awojak/P600-Main-Board/README.md

# P600-Main-Board
Project of Main Board for P600. Design in KiCad.
