awojak/P600-Main-Board/BOM.xlsx

Sheet: New
Reference | Model | Producent | Value | Quantity | Cena jednostkowa | Cena | Opis | Footprint | Link | Typ | Stan Magazynowy | Minimalne zamówienie
C14 C11 C12 C13 C28 C25 C26 C27 | C0805C471J1GAC | KEMET | 470pF | 8 | 0.09147 | 0.73176 |  | Capacitor_SMD:C_0805_2012Metric | https://www.tme.eu/pl/details/c0805c471j1gac/kondensatory-mlcc-smd-0805/kemet/c0805c471j1gactu/ | SMD
C3 C2 C91 C90 C15 C1 | EEUFR1H121L | Panasonic | 120uF | 6 | 1.074 | 6.444 | Kondensator: elektrolityczny; niskoimpedancyjny; THT; 120uF; ±20% | Capacitor_THT:CP_Radial_D8.0mm_P3.50mm | https://www.tme.eu/pl/details/eeufr1h121l/kondensatory-elektr-tht-niskoimpedan/panasonic/ | THT
C30 C29 | C0603C200J5GAC | KEMET | 20pF | 2 | 0.14766 | 0.29532 |  | Capacitor_SMD:C_0603_1608Metric | https://www.tme.eu/pl/details/c0603c200j5gac/kondensatory-mlcc-smd-0603/kemet/c0603c200j5gactu/ | SMD
C36 C93 | CL21B105KBFNNNE | SAMSUNG | 1uF | 2 | 0.09 | 0.18 |  | Capacitor_SMD:C_0603_1608Metric |  | SMD | 100
C4 C87 C16 C92 | CL32B106KBJNNNE | SAMSUNG | 10uF | 4 | 1.4525 | 5.81 | Kondensator: ceramiczny; MLCC; 10uF; 50V; X7R; ±10%; SMD; 1210 | Capacitor_SMD:C_1210_3225Metric | https://www.tme.eu/pl/details/cl32b106kbjnnne/kondensatory-mlcc-smd-1210/samsung/ | SMD
C5 C6 C8 C10 C89 C19 C20 C22 C24 C18 C31 C37 C38 C39 C40 C41 C42 C35 C34 C94 C47 C43 C44 C45 C46 C48 C61 C51 C69 C70 C68 C67 C75 C84 C77 C81 C82 C79 C80 C78 C83 C95 | CL10B104KB8NNNC | SAMSUNG | 0.1uF | 42 | 0.05982 | 2.51244 |  | Capacitor_SMD:C_0603_1608Metric |  | SMD | 100
C54 C55 C50 C52 C53 C49 | CL31B225KBHNNNE | SAMSUNG | 2.2uF | 6 | 0.68179 | 4.09074 |  | Capacitor_SMD:C_1206_3216Metric | https://www.tme.eu/pl/details/cl31b225kbhnnne/kondensatory-mlcc-smd-1206/samsung/ | SMD | 100
C56 |  |  | 47nF | 1 | 0 | 0 |  | Capacitor_SMD:C_0603_1608Metric |  | SMD
C60 | CL10B102KB8NNNC | SAMSUNG | 1nF | 1 | 0.05563 | 0.05563 | Kondensator: ceramiczny; MLCC; 1nF; 50V; X7R; ±10%; SMD; 0603 | Capacitor_SMD:C_0603_1608Metric | https://www.tme.eu/pl/details/cl10b102kb8nnnc/kondensatory-mlcc-smd-0603/samsung/ | SMD
C62 C64 C63 C57 C58 C65 | CL31B106KAHNNNE | SAMSUNG | 10uF | 6 | 0.26552 | 1.59312 |  | Capacitor_SMD:C_1206_3216Metric |  | SMD
C66 C86 C85 |  |  | 0.01uF | 3 | 0 | 0 |  | Capacitor_SMD:C_0603_1608Metric |  | SMD
C7 C21 C59 | CC0603KRX7R9223 | YAGEO | 22nF | 3 | 0.07284 | 0.21852 |  | Capacitor_SMD:C_0603_1608Metric | https://www.tme.eu/pl/details/cc0603krx7r9223/kondensatory-mlcc-smd-0603/yageo/cc0603krx7r9bb223/ | SMD
C73 C71 C74 C72 |  |  | NI | 4 | 0 | 0 |  | Capacitor_SMD:C_0603_1608Metric |  | SMD
C76 |  |  | NI | 1 | 0 | 0 |  | Capacitor_SMD:C_0805_2012Metric |  | SMD
C88 C17 | CL21B105KBFNNNE | SAMSUNG | 1uF | 2 | 0.09 | 0.18 |  | Capacitor_SMD:C_0805_2012Metric |  | SMD
C9 C23 C33 C32 | CL10A225KP8NNNC | SAMSUNG | 2.2uF | 4 | 0.08 | 0.32 |  | Capacitor_SMD:C_0603_1608Metric | https://www.tme.eu/pl/details/cl10a225kp8nnnc/kondensatory-mlcc-smd-0603/samsung/ | SMD
D1 D4 D3 D2 D6 D5 D7 D10 D9 D8 D12 D11 D18 D38 D39 |  | STM | SMAJ26CA | 15 | 0.3 | 4.5 | Dioda: transil; 400W; 28,9V; 43A; dwukierunkowa; SMA | Diode_SMD:D_SMA | https://www.tme.eu/pl/details/smaj26ca-tr/diody-transil-smd-dwukierunkowe/stmicroelectronics/smaj26ca/ | SMD
D13 D16 | OF-SMD2012G-1 | OPTOFLASH | OF-SMD2012G-1 | 2 | 0.34 | 0.68 | LED; SMD; 0805; zielony; 600-800mcd; 2x1,25x0,68mm; 120°; 2,8-3,4V | Diode_SMD:D_0805_2012Metric | https://www.tme.eu/pl/details/of-smd2012g-1/diody-led-smd-kolorowe/optoflash/ | SMD
D14 D15 D35 D36 D37 D45 D44 | SD05C.TCT | SEMTECH | SD05C.TCT | 7 | 0.9302 | 6.5114 | Dioda: transil; 350W; 6V; 24A; dwukierunkowa; SOD323 | Diode_SMD:D_SOD-323 | https://www.tme.eu/pl/details/sd05c.tct/diody-transil-smd-dwukierunkowe/semtech/ | SMD
D20 | MMSZ5240B-7-F | DIODES INCORPORATED | MMSZ5240B-7-F | 1 | 0.10646 | 0.10646 | Dioda: Zenera; 0,37/0,5W; 10V; SMD; rolka,taśma; SOD123 | Diode_SMD:D_SOD-123 | https://www.tme.eu/pl/details/mmsz5240b-7-f/diody-zenera-smd/diodes-incorporated/ | SMD
D24 | MMSZ5236BS-7-F | DIODES INCORPORATED | MMSZ5236BS-7-F | 1 | 0.14862 | 0.14862 | Dioda: Zenera; 0,2W; 7,5V; SMD; rolka,taśma; SOD323 | Diode_SMD:D_SOD-323 | https://www.tme.eu/pl/details/mmsz5236bs-7-f/diody-zenera-smd/diodes-incorporated/ | SMD
D25 D22 | B140-13-F | DIODES INCORPORATED | B140-13-F | 2 | 0.2938 | 0.5876 | Dioda: prostownicza Schottky; SMD; 40V; 1A; SMA | Diode_SMD:D_SMA | https://www.tme.eu/pl/details/b140-13-f/diody-schottky-smd/diodes-incorporated/ | SMD
D26 | SK35SMA | DIODES INCORPORATED | SK35SMA | 1 | 0.3496 | 0.3496 | Dioda: prostownicza Schottky; SMD; 50V; 3A; SMA | Diode_SMD:D_SMA | https://www.tme.eu/pl/details/sk35sma-dio/diody-schottky-smd/diotec-semiconductor/sk35sma/ | SMD
D27 D23 D29 D34 D28 D30 D31 D32 D33 | 1N4448WS-7-F | DIODES INCORPORATED | 1N4448WS-7-F | 9 | 0.14905 | 1.34145 | Dioda: prostownicza; SMD; 75V; 0,25A; 4ns; | Diode_SMD:D_SOD-323 | https://www.tme.eu/pl/details/1n4448ws-7-f/diody-uniwersalne-smd/diodes-incorporated/ | SMD
D43 D42 D41 D40 | SKL32 | DIOTEC SEMICONDUCTOR | SKL32 | 4 | 0.3028 | 1.2112 | Dioda: prostownicza Schottky; SMD; 20V; 3A; SOD123F | Diode_SMD:D_SOD-123F | https://www.tme.eu/pl/details/skl32-dio/diody-schottky-smd/diotec-semiconductor/skl32/ | SMD
F1 | 0ZCF0185FF2C | BEL FUSE | 0ZCF0185FF2C | 1 | 0.8689 | 0.8689 | Bezpiecznik: polimerowy PTC; 1,85A; Imax: 100A; Obud: 2920; 0ZCF | Fuse:Fuse_2920_7451Metric | https://www.tme.eu/pl/details/0zcf0185ff2c/bezpieczniki-polimerowe-smd/bel-fuse/ | SMD
F2 F3 | 0ZCJ0050AF2E | BEL FUSE | 0ZCJ0050AF2E | 2 | 0.6728 | 1.3456 | Bezpiecznik: polimerowy PTC; 500mA; Imax: 100A; Obud: 1206; 0ZCJ | Fuse:Fuse_1206_3216Metric | https://www.tme.eu/pl/details/0zcj0050af2e/bezpieczniki-polimerowe-smd/bel-fuse/ | SMD
F4 | 0ZCK0100FF2E | BEL FUSE | 0ZCK0100FF2E | 1 | 1.04 | 1.04 | Bezpiecznik: polimerowy PTC; 1A; Imax: 40A; Obud: 0805; 0ZCK | Fuse:Fuse_0805_2012Metric | https://www.tme.eu/pl/details/0zck0100ff2e/bezpieczniki-polimerowe-smd/bel-fuse/ | SMD
F5 F7 | SR050-06 | ECE | SR050 | 2 | 0.906 | 1.812 | Bezpiecznik: polimerowy PTC; 500mA; Obud: 0805 | Fuse:Fuse_0805_2012Metric | https://www.tme.eu/pl/details/sr050-06/bezpieczniki-polimerowe-smd/ece/ | SMD
F6 | SN010-60 | ECE | SN010-60 | 1 | 0.3763 | 0.3763 | Bezpiecznik: polimerowy PTC; 100mA; Obud: 1206 | Fuse:Fuse_1206_3216Metric | https://www.tme.eu/pl/details/sn010-60/bezpieczniki-polimerowe-smd/ece/ | SMD
FB1 FB2 FB3 FB4 FB5 FB6 FB7 FB8 | BLM21PG600SN1D | MURATA | 60Ohm@100MHz | 8 | 0.13674 | 1.09392 | Ferryt: koralik; Imp.@ 100MHz: 60Ω; Montaż: SMD; 3A; Obud: 0805 | Inductor_SMD:L_0805_2012Metric | https://www.tme.eu/pl/details/blm21pg600sn1d/ferryty-koraliki/murata/ | SMD
FB9 | BLM18TG601TN1D | MURATA | 600Ohm@100MHz | 1 | 0.03481 | 0.03481 | Ferryt: koralik; Imp.@ 100MHz: 600Ω; Montaż: SMD; 0.2A; Obud: 0603 | Inductor_SMD:L_0603_1608Metric | https://www.tme.eu/pl/details/blm18tg601tn1d/ferryty-koraliki/murata/ | SMD
J3 | MC32597 | MULTICOMP PRO | USB_B | 1 | 2.73 | 2.73 | Złącze USB, USB typu B, USB 2.0, Gniazdo, 4 tory/-ów, Montaż przewlekany, Pionowe | Connector_USB:USB_B_TE_5787834_Vertical | https://pl.farnell.com/multicomp/mc32597/usb-2-0-type-b-receptacle-th/dp/1696538?MER=sy-me-pd-mi-alte | THT
J1 J2 | B4B-XH-A | JST |  | 2 | 0.81567 | 1.63134 | Gniazdo; przewód-płytka; męskie; XH; 2,5mm; PIN: 4; THT; 250V; 3A | Connector_JST:JST_XH_B4B-XH-AM_1x04_P2.50mm_Vertical | https://www.tme.eu/pl/details/b4b-xh-a/zlacza-sygnalowe-raster-2-50mm/jst/ | THT | 5
J10 J11 |  |  |  | 2 | 0.8 | 1.6 |  | footprints:THT_FPC_r1.0mm_11pin_vertical | https://pl.aliexpress.com/item/33053158233.html?spm=a2g0o.cart.0.0.1df73c00waDDo7&mp=1 | THT
J43 J33 J32 J29 J28 J27 J25 J21 J12 J13 J14 J15 J5 | B3B-PH-K-S | JST |  | 13 | 0.59599 | 7.74787 | Gniazdo; przewód-płytka; męskie; PH; 2mm; PIN: 3; THT; 100V; 2A | Connector_JST:JST_PH_B3B-PH-K_1x03_P2.00mm_Vertical | https://www.tme.eu/pl/details/b3b-ph-k-s/zlacza-sygnalowe-raster-2-00mm/jst/ | THT
J16 | B2B-XH-A | JST | Power Input | 1 | 0.49272 | 0.49272 | Gniazdo; przewód-płytka; męskie; XH; 2,5mm; PIN: 2; THT; 250V; 3A | Connector_JST:JST_XH_B2B-XH-AM_1x02_P2.50mm_Vertical | https://www.tme.eu/pl/details/b2b-xh-a/zlacza-sygnalowe-raster-2-50mm/jst/ | THT | 10
J42 J41 J40 J39 J38 J37 J31 J30 J24 J23 J22 J20 J17 J18 J19 J6 J7 J8 J9 | B2B-PH-K-S | JST |  | 19 | 0.47429 | 9.01151 | Gniazdo; przewód-płytka; męskie; PH; 2mm; PIN: 2; THT; 100V; 2A | Connector_JST:JST_PH_B2B-PH-K_1x02_P2.00mm_Vertical | https://www.tme.eu/pl/details/b2b-ph-k-s/zlacza-sygnalowe-raster-2-00mm/jst/ | THT | 20
J36 J26 | B4B-PH-K-S | JST | ANALOG | 2 | 0.78136 | 1.56272 | Gniazdo; przewód-płytka; męskie; PH; 2mm; PIN: 4; THT; 100V; 2A | Connector_JST:JST_PH_B4B-PH-K_1x04_P2.00mm_Vertical | https://www.tme.eu/pl/details/b4b-ph-k-s/zlacza-sygnalowe-raster-2-00mm/jst/ | THT | 5
J34 | B10B-PH-K-S | JST | Display | 1 | 1.33 | 1.33 | Złącze przewód-płytka, pionowe, 2 mm, 10 styki/-ów, Header, Seria PH, Przewlekane, 1 rzędy/-ów | Connector_JST:JST_PH_B10B-PH-K_1x10_P2.00mm_Vertical | https://pl.farnell.com/jst-japan-solderless-terminals/b10b-ph-k-s-lf-sn/header-tht-vertical-2mm-10way/dp/9491880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 | THT
J35 | B5B-PH-K-S | JST | SPI Interface | 1 | 0.90501 | 0.90501 | Gniazdo; przewód-płytka; męskie; PH; 2mm; PIN: 5; THT; 100V; 2A | Connector_JST:JST_PH_B5B-PH-K_1x05_P2.00mm_Vertical | https://www.tme.eu/pl/details/b5b-ph-k-s/zlacza-sygnalowe-raster-2-00mm/jst/ | THT | 5
K1 | S13-24V-2C | SHORI ELECTRIC | S13-24V-2C | 1 | 4.46 | 4.46 | Przekaźnik: elektromagnetyczny; DPDT; Ucewki : 24VDC; 0,5A/125VAC | footprints:Relay_DPDT_Omron_G5V-2 | https://www.tme.eu/pl/details/s13-24v-2c/przekazniki-elektromagn-miniaturowe/shori-electric/ | THT | 2
L1 | DJNR6045-150 | FERROCORE | DJNR6045-680 | 1 | 0.7018 | 0.7018 | Dławik: drutowy; SMD; 15uH; Ipracy: 2,3A; 100,1mΩ; 6x5,9x4,5mm; ±20% | footprints:L_6.2x6.2_H4.5 | https://www.tme.eu/pl/details/djnr6045-150/dlawiki-smd-mocy/ferrocore/ | SMD
L2 | DJNR6045-150 | FERROCORE | DJNR6045-150 | 1 | 0.7018 | 0.7018 | Dławik: drutowy; SMD; 15uH; Ipracy: 2,3A; 100,1mΩ; 6x5,9x4,5mm; ±20% | footprints:L_6.2x6.2_H4.5 | https://www.tme.eu/pl/details/djnr6045-150/dlawiki-smd-mocy/ferrocore/ | SMD
L3 | DJNR6045-6R8 | FERROCORE | DJNR6045-6R8 | 1 | 0.7018 | 0.7018 | Dławik: drutowy; SMD; 6,8uH; Ipracy: 3,5A; 49,4mΩ; 6x5,9x4,5mm; ±20% | footprints:L_6.2x6.2_H4.5 | https://www.tme.eu/pl/details/djnr6045-6r8/dlawiki-smd-mocy/ferrocore/ | SMD
Q1 Q2 Q3 Q4 Q6 Q5 Q7 Q10 Q9 Q14 Q15 Q16 Q19 Q18 Q20 Q21 | 2N7002KT1G | ON SEMICONDUCTOR | 2N7002K | 16 | 0.08831 | 1.41296 | Tranzystor: N-MOSFET ESD Protected; unipolarny; 60V; 0,38A; 0,42W; SOT23-3 | Package_TO_SOT_SMD:SOT-23 | https://www.tme.eu/pl/details/2n7002kt1g/tranzystory-z-kanalem-n-smd/on-semiconductor/ | SMD
Q11 Q12 Q13 Q17 | BC817.215 | NEXPERIA | BC817 | 4 | 0.1189 | 0.4756 | Tranzystor: NPN; bipolarny; 45V; 0,5A; 250mW; SOT23 | Package_TO_SOT_SMD:SOT-23 | https://www.tme.eu/pl/details/bc817.215/tranzystory-npn-smd/nexperia/ | SMD | 100
Q8 | YJS9435A | YANGJIE TECHNOLOGY | YJS9435A | 1 | 0.29736 | 0.29736 | Tranzystor: P-MOSFET; TRENCH POWER LV; unipolarny; -30V; -4,1A | Package_SO:SOP-8_3.9x4.9mm_P1.27mm | https://www.tme.eu/pl/details/yjs9435a-yan/tranzystory-z-kanalem-p-smd/yangjie-technology/yjs9435a/ | SMD
R10 R53 |  |  | 47Ω | 2 | 0.04651 | 0.09302 |  | Resistor_SMD:R_0603_1608Metric |  | SMD
R12 R11 R57 R51 R60 R63 R80 R104 R108 R105 R109 R102 R106 R103 R107 R117 R118 R119 R120 R1 | 0603SAF1002T5E | ROYAL OHM | 10kΩ | 20 | 0.03622 | 0.7244 | Rezystor: thick film; SMD; 0603; 10kΩ; 0,1W; ±1%; -55-155°C | Resistor_SMD:R_0603_1608Metric | https://www.tme.eu/pl/details/smd0603-10k-1%25/rezystory-smd-0603/royal-ohm/0603saf1002t5e/ | SMD
R13 R33 R34 R32 R36 R37 R111 |  |  | 0Ω | 7 | 0.04651 | 0.32557 |  | Resistor_SMD:R_0603_1608Metric |  | SMD
R14 R17 R100 R101 R47 |  |  | 330Ω | 5 | 0.04651 | 0.23255 |  | Resistor_SMD:R_0603_1608Metric |  | SMD
R18 R19 R20 R21 R62 R61 R112 R110 | SMD0603-4K7-1% | ROYAL OHM | 2.2kΩ | 8 | 0.04651 | 0.37208 | Rezystor: thick film; SMD; 0603; 4,7kΩ; 0,1W; ±1%; -55-155°C | Resistor_SMD:R_0603_1608Metric | https://www.tme.eu/pl/details/smd0603-4k7-1%25/rezystory-smd-0603/royal-ohm/0603saf4701t5e/ | SMD
R2 R6 R31 R42 R43 R44 | 0603SAF1001T5E | ROYAL OHM | 1kΩ | 6 | 0.04651 | 0.27906 | Rezystor: thick film; SMD; 0603; 1kΩ; 0,1W; ±1%; -55-155°C | Resistor_SMD:R_0603_1608Metric | https://www.tme.eu/pl/details/smd0603-1k-1%25/rezystory-smd-0603/royal-ohm/0603saf1001t5e/ | SMD
R22 R23 R24 R25 R38 R30 R41 R66 R65 R86 R85 R87 R98 R99 R113 R114 | 0603SAF1000T5E | ROYAL OHM | 100Ω | 16 | 0.03185 | 0.5096 | Rezystor: thick film; SMD; 0603; 100Ω; 0,1W; ±1%; -55-155°C | Resistor_SMD:R_0603_1608Metric | https://www.tme.eu/pl/details/smd0603-100r-1%25/rezystory-smd-0603/royal-ohm/0603saf1000t5e/ | SMD
R26 R27 R28 R29 R40 R72 R73 R71 R70 R84 R93 R115 R116 | 0603SAJ0473T5E | ROYAL OHM | 20kΩ | 13 | 0.03572 | 0.46436 | Rezystor: thick film; SMD; 0603; 47kΩ; 0,1W; ±5%; -55-155°C | Resistor_SMD:R_0603_1608Metric | https://www.tme.eu/pl/details/smd0603-47k/rezystory-smd-0603/royal-ohm/0603saj0473t5e/ | SMD
R3 R7 R39 R52 R48 R64 R68 R82 R67 R69 R83 R91 R95 R94 R92 |  |  | 100kΩ | 15 | 0.04651 | 0.69765 |  | Resistor_SMD:R_0603_1608Metric |  | SMD
R35 R81 R74 R75 R78 R76 R77 R79 |  |  | NI | 8 | 0 | 0 |  | Resistor_SMD:R_0603_1608Metric |  | SMD
R4 R5 R8 R9 | CS10FTFTR100 | VIKING | 100mΩ | 4 | 0.76246 | 3.04984 | Rezystor: thick film; pomiarowy; SMD; 2010; 100mΩ; 1W; ±1% | Resistor_SMD:R_2010_5025Metric | https://www.tme.eu/pl/details/cs2010-0r1-1%25-hp/rezystory-smd-2010/viking/cs10ftftr100/ | SMD
R45 |  |  | 10kΩ | 1 | 0.04651 | 0.04651 |  | Resistor_SMD:R_0805_2012Metric |  | SMD
R50 | MCWR06X3162FTL | MULTICOMP PRO | 140kΩ | 1 | 0.02 | 0.02 | Rezystor SMD, grubowarstwowy, 0603 [jedn. metryczne: 1608], 31.6 kohm, Seria MCWR, 75 V | Resistor_SMD:R_0603_1608Metric | https://pl.farnell.com/multicomp/mcwr06x3162ftl/res-31k6-1-0-1w-thick-film/dp/2447337RL | SMD
R55 R54 | 6-1622825-5 | TE Connectivity | 100mΩ | 2 | 0.33547 | 0.67094 | Rezystor: metal glaze; SMD; 1206; 100mΩ; 0,25W; ±5%; 200ppm/°C | Resistor_SMD:R_1206_3216Metric | https://www.tme.eu/pl/details/smd1206-r10-lo/rezystory-smd-1206/te-connectivity/6-1622825-5/ | SMD
R56 | MCWR06X3162FTL | MULTICOMP PRO | 31.2kΩ | 1 | 0.02 | 0.02 | Rezystor SMD, grubowarstwowy, 0603 [jedn. metryczne: 1608], 31.6 kohm, Seria MCWR, 75 V | Resistor_SMD:R_0603_1608Metric | https://pl.farnell.com/multicomp/mcwr06x3162ftl/res-31k6-1-0-1w-thick-film/dp/2447337RL | SMD
R58 | 0603SAF3921T5E | ROYAL OHM | 3.92kΩ | 1 | 0.05158 | 0.05158 | Rezystor: thick film; SMD; 0603; 3,92kΩ; 0,1W; ±1%; -55-155°C | Resistor_SMD:R_0603_1608Metric | https://www.tme.eu/pl/details/smd0603-3.92k-1%25/rezystory-smd-0603/royal-ohm/0603saf3921t5e/ | SMD
R59 |  |  | 750Ω | 1 | 0.04651 | 0.04651 |  | Resistor_SMD:R_0603_1608Metric |  | SMD
R88 |  |  | 0Ω | 1 | 0 | 0 |  | Resistor_SMD:R_0805_2012Metric |  | SMD
R89 R90 |  |  | NI | 2 | 0 | 0 |  | Resistor_SMD:R_0805_2012Metric |  | SMD
R96 R97 |  |  | 20Ω | 2 | 0 | 0 |  | Resistor_SMD:R_0603_1608Metric |  | SMD
RN1 RN2 RN3 RN4 | 4D03WGJ0331T | ROYAL OHM | 330Ω | 4 | 0.04823 | 0.19292 | Drabinka rezystorowa: Y; 330Ω; SMD; 1206; Il.rezystorów: 4; 63mW | Resistor_SMD:R_Array_Convex_4x0603 | https://www.tme.eu/pl/details/dr1206-330r-4_8/drabinki-rezystorowe-smd/royal-ohm/4d03wgj0331t/ | SMD
U1 U2 | TMC2209-LA-T | TRINAMIC | TMC2209-LA | 2 | 10.3 | 20.6 | Sterownik/kontroler silnika krokowego, 4.75V do 29V, 2A/1 wyjście, QFN-28 | footprints:QFN-28_5X5mm_P0.5mm_EP3.35x.3.35mm | https://pl.farnell.com/trinamic/tmc2209-la-t/motor-driver-stepper-qfn-28/dp/3131535?st=TMC2209 | SMD
U10 | 74HC2G32DC.125 | NEXPERIA | 74HC2G32 | 1 | 1.1252 | 1.1252 | IC: cyfrowy; OR; Kanały: 2; IN: 4; CMOS; SMD; VSSOP8; Seria: HC; 2-6VDC | Package_SO:VSSOP-8_2.3x2mm_P0.5mm | https://www.tme.eu/pl/details/74hc2g32dc.125/bramki-inwertery/nexperia/ | SMD
U12 | SHTC3 | SENSIRION | SHTC3 | 1 | 7.2 | 7.2 | Czujnik: temperatury i wilgotności; Zakres: 0-100% RH; -0,3-4VDC | footprints:DFN-4-1EP_2x2mm_P1mm_EP0.7x1.6mm | https://www.tme.eu/pl/details/shtc3/czujniki-wilgotnosci/sensirion/3-000-047/ | SMD | 2
U13 | M24C02-WDW6TP | ST | M24C02-WDW | 1 | 0.56 | 0.56 | EEPROM, 2 Kbit, 256 x 8 bitów, Szeregowy I2C (2-Wire), 400 kHz, TSSOP, 8 piny/-ów | Package_SO:TSSOP-8_4.4x3mm_P0.65mm | https://pl.farnell.com/stmicroelectronics/m24c02-wdw6tp/eeprom-2kbit-i2c-400khz-tssop/dp/2849956RL | SMD
U3 | STM32F401VBT6 | STM | STM32F401VETx | 1 | 22.53 | 22.53 | ARM MCU, linia Dynamic Efficiency, STM32 Family STM32F4 Series Microcontrollers, ARM Cortex-M4 | Package_QFP:LQFP-100_14x14mm_P0.5mm | https://pl.farnell.com/stmicroelectronics/stm32f401vbt6/mcu-32bit-cortex-m4-84mhz-lqfp/dp/2393646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 | SMD | 2
U4 | USBUF02W6 | STM | USBUF02W6 | 1 | 1.0587 | 1.0587 | Filtr: cyfrowy; line terminator; EMI,dolnoprzepustowy; SOT323-6L | footprints:SOT323-6L | https://www.tme.eu/pl/details/usbuf02w6/filtry-uklady-scalone/stmicroelectronics/ | SMD | 25
U5 U11 | 74HC245PW.112 | NEXPERIA | 74HC245 | 2 | 0.974 | 1.948 | IC: cyfrowy; bus transceiver; Kanały: 8; SMD; TSSOP20; Seria: HC | Package_SO:TSSOP-20_4.4x6.5mm_P0.65mm | https://www.tme.eu/pl/details/74hc245pw.112/bufory-nadajniki-sterowniki/nexperia/ | SMD | 4
U7 | A4403GEUTR-T | ALLEGRO | A4403 | 1 | 6.66 | 6.66 | PMIC; przetwornica DC/DC; Upracy: 9-46V; Uwyj: 46V; QFN16; buck | Package_DFN_QFN:QFN-16-1EP_4x4mm_P0.65mm_EP2.7x2.7mm | https://www.tme.eu/pl/details/a4403geutr-t/regulatory-napiecia-uklady-dc-dc/allegro-microsystems/ | SMD | 2
U8 U6 | MCP16301T-I/CHY | MICROCHIP | MCP16301 | 2 | 3.82 | 7.64 | PMIC; przetwornica DC/DC; Upracy: 4-30V; Uwyj: 2-15V; SOT23-6; buck | Package_TO_SOT_SMD:SOT-23-6 | https://www.tme.eu/pl/details/mcp16301t-i_chy/regulatory-napiecia-uklady-dc-dc/microchip-technology/ | SMD | 2
U9 | MCP6002T-I/SN | MICROCHIP | MCP6002-xSN | 1 | 2.07 | 2.07 | Wzmacniacz operacyjny; 1MHz; 1,8-5,5V; Kanały: 2; SO8 | Package_SO:SOIC-8_3.9x4.9mm_P1.27mm | https://www.tme.eu/pl/details/mcp6002t-i_sn/wzmacniacze-operacyjne-smd/microchip-technology/ | SMD
Y1 | 8M-49S-SR | SR PASSIVES | 8MHz | 1 | 1.6356 | 1.6356 | Rezonator: kwarcowy; 8MHz; ±30ppm; 20pF; THT; HC49-S | Crystal:Crystal_HC49-4H_Vertical | https://www.tme.eu/pl/details/8m-49s-sr/rezonatory-kwarcowe-tht/sr-passives/ | THT | 5
Płytka PCB |  |  |  | 1 | 31 | 31 |  |  |  |  |  | 5
 |  |  |  | Razem |  | 192.02597

Sheet: BOM KiCad
Reference | Quantity | Value | Footprint | Cena [netto] | Link | Model | Opis | Producent | Typ
Q4 | 1 | YJS9435A | Package_SO:SOP-8_3.9x4.9mm_P1.27mm | 0.30 | https://www.tme.eu/pl/details/yjs9435a-yan/tranzystory-z-kanalem-p-smd/yangjie-technology/yjs9435a/ | YJS9435A | Tranzystor: P-MOSFET; TRENCH POWER LV; unipolarny; -30V; -4,1A | YANGJIE TECHNOLOGY | SMD
U4 | 1 | USBUF02W6 | footprints:SOT323-6L | 1.06 | https://www.tme.eu/pl/details/usbuf02w6/filtry-uklady-scalone/stmicroelectronics/ | USBUF02W6 | Filtr: cyfrowy; line terminator; EMI,dolnoprzepustowy; SOT323-6L | STM | SMD
U1 U2 | 2 | TMC2209-LA | footprints:TMC2209-LA | 10.30 | https://pl.farnell.com/trinamic/tmc2209-la-t/motor-driver-stepper-qfn-28/dp/3131535?st=TMC2209 | TMC2209-LA-T | Sterownik/kontroler silnika krokowego, 4.75V do 29V, 2A/1 wyjĹ›cie, QFN-28 | TRINAMIC | SMD
J4 | 1 | SWD | Connector_IDC:IDC-Header_2x03_P2.54mm_Vertical | 1.58 | https://www.tme.eu/pl/details/t821-1-06-s1/zlacza-idc/amphenol/t821106a1s100ceu/ | T821106A1S100CEU | Gniazdo; IDC; mÄ™skie; PIN: 6; proste; THT; zĹ‚ocony; 2,54mm; UkĹ‚ad: 2x3 | AMPHENOL | THT
U3 | 1 | STM32F401VETx | Package_QFP:LQFP-100_14x14mm_P0.5mm | 22.53 | https://pl.farnell.com/stmicroelectronics/stm32f401vbt6/mcu-32bit-cortex-m4-84mhz-lqfp/dp/2393646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 | STM32F401VBT6 | ARM MCU, linia Dynamic Efficiency, STM32 Family STM32F4 Series Microcontrollers, ARM Cortex-M4 | STM | SMD
F2 F1 F8 | 3 | SR050 | Fuse:Fuse_0805_2012Metric | 0.91 | https://www.tme.eu/pl/details/sr050-06/bezpieczniki-polimerowe-smd/ece/ | SR050-06 | Bezpiecznik: polimerowy PTC; 500mA; Obud: 0805 | ECE | SMD
F7 F9 | 2 | SR010 | Fuse:Fuse_0805_2012Metric | 0.62 | https://www.tme.eu/pl/details/sr010-15/bezpieczniki-polimerowe-smd/ece/ | SR010-15 | Bezpiecznik: polimerowy PTC; 100mA; Obud: 0805 | ECE | SMD
F4 F5 F6 | 3 | SN010-60 | Fuse:Fuse_1206_3216Metric | 0.38 | https://www.tme.eu/pl/details/sn010-60/bezpieczniki-polimerowe-smd/ece/ | SN010-60 | Bezpiecznik: polimerowy PTC; 100mA; Obud: 1206 | ECE | SMD
R33 R31 R20 R21 R18 R19 R35 R66 R67 R64 R65 R60 R61 | 13 | 4.7kÎ© | Resistor_SMD:R_0603_1608Metric | 0.05 | https://www.tme.eu/pl/details/smd0603-4k7-1%25/rezystory-smd-0603/royal-ohm/0603saf4701t5e/ | SMD0603-4K7-1% | Rezystor: thick film; SMD; 0603; 4,7kÎ©; 0,1W; Â±1%; -55Ă·155Â°C | ROYAL OHM | SMD
D25 | 1 | SK35SMA | Diode_SMD:D_SMA | 0.35 | https://www.tme.eu/pl/details/sk35sma-dio/diody-schottky-smd/diotec-semiconductor/sk35sma/ | SK35SMA | Dioda: prostownicza Schottky; SMD; 50V; 3A; SMA | DIODES INCORPORATED | SMD
D7 D5 D3 D1 D2 D4 D6 D8 D15 D13 D11 D9 D10 D12 D14 D16 | 16 | SK25 | Diode_SMD:D_SMB | 0.24 | https://www.tme.eu/pl/details/sk25-dio/diody-schottky-smd/diotec-semiconductor/sk25/ | SK25 | Dioda: prostownicza Schottky; SMD; 50V; 2A; SMB | DIOTEC SEMICONDUCTOR | SMD
U10 | 1 | SHTC3 | footprints:DFN-4-1EP_2x2mm_P1mm_EP0.7x1.6mm | 7.20 | https://www.tme.eu/pl/details/shtc3/czujniki-wilgotnosci/sensirion/3-000-047/ | SHTC3 | Czujnik: temperatury i wilgotnoĹ›ci; Zakres: 0Ă·100% RH; -0,3Ă·4VDC | SENSIRION | SMD
K1 | 1 | S13-24V-2C | footprints:Relay_DPDT_Omron_G5V-2 | 4.46 | https://www.tme.eu/pl/details/s13-24v-2c/przekazniki-elektromagn-miniaturowe/shori-electric/ | S13-24V-2C | PrzekaĹşnik: elektromagnetyczny; DPDT; Ucewki : 24VDC; 0,5A/125VAC | SHORI ELECTRIC | THT
D20 | 1 | P4SMA30CA | Diode_SMD:D_SMA | 0.61 | https://www.tme.eu/pl/details/p4sma30ca-yan/diody-transil-smd-dwukierunkowe/yangjie-technology/p4sma30ca/ | P4SMA30CA | Dioda: transil; 400W; 30V; 9,6A; dwukierunkowa; Â±5% | YANGJIE TECHNOLOGY | SMD
D17 D23 D19 D21 | 4 | OF-SMD2012G-1 | Diode_SMD:D_0805_2012Metric | 0.34 | https://www.tme.eu/pl/details/of-smd2012g-1/diody-led-smd-kolorowe/optoflash/ | OF-SMD2012G-1 | LED; SMD; 0805; zielony; 600Ă·800mcd; 2x1,25x0,68mm; 120Â°; 2,8Ă·3,4V | OPTOFLASH | SMD
D22 | 1 | MMSZ5240B-7-F | Diode_SMD:D_SOD-123 | 0.11 | https://www.tme.eu/pl/details/mmsz5240b-7-f/diody-zenera-smd/diodes-incorporated/ | MMSZ5240B-7-F | Dioda: Zenera; 0,37/0,5W; 10V; SMD; rolka,taĹ›ma; SOD123 | DIODES INCORPORATED | SMD
R45 | 1 | 31.2kÎ© | Resistor_SMD:R_0603_1608Metric | 0.02 | https://pl.farnell.com/multicomp/mcwr06x3162ftl/res-31k6-1-0-1w-thick-film/dp/2447337RL | MCWR06X3162FTL | Rezystor SMD, grubowarstwowy, 0603 [jedn. metryczne: 1608], 31.6 kohm, Seria MCWR, 75 V | MULTICOMP PRO | SMD
U7 | 1 | MCP16301 | Package_TO_SOT_SMD:SOT-23-6 | 3.82 | https://www.tme.eu/pl/details/mcp16301t-i_chy/regulatory-napiecia-uklady-dc-dc/microchip-technology/ | MCP16301T-I/CHY | PMIC; przetwornica DC/DC; Upracy: 4Ă·30V; Uwyj: 2Ă·15V; SOT23-6; buck | MICROCHIP | SMD
C1 C15 | 2 | 330uF | Capacitor_THT:CP_Radial_D10.0mm_P5.00mm | 0.67 |  | ED1H331MNN1025 |  | Elite | THT
L2 | 1 | DJNR6045-6R8 | footprints:L_6.2x6.2_H4.5 | 0.70 | https://www.tme.eu/pl/details/djnr6045-6r8/dlawiki-smd-mocy/ferrocore/ | DJNR6045-6R8 | DĹ‚awik: drutowy; SMD; 6,8uH; Ipracy: 3,5A; 49,4mÎ©; 6x5,9x4,5mm; Â±20% | FERROCORE | SMD
L1 | 1 | DJNR6045-150 | footprints:L_6.2x6.2_H4.5 | 0.70 | https://www.tme.eu/pl/details/djnr6045-150/dlawiki-smd-mocy/ferrocore/ | DJNR6045-150 | DĹ‚awik: drutowy; SMD; 15uH; Ipracy: 2,3A; 100,1mÎ©; 6x5,9x4,5mm; Â±20% | FERROCORE | SMD
R4 R5 R8 R9 | 4 | 100mÎ© | Resistor_SMD:R_2010_5025Metric | 0.76 | https://www.tme.eu/pl/details/cs2010-0r1-1%25-hp/rezystory-smd-2010/viking/cs10ftftr100/ | CS10FTFTR100 | Rezystor: thick film; pomiarowy; SMD; 2010; 100mÎ©; 1W; Â±1% | VIKING | SMD
C2 C16 | 2 | 10uF | Capacitor_SMD:C_1210_3225Metric | 1.45 |  | CL32B106KBJNNNE |  | SAMSUNG | SMD
C49 C50 | 2 | 2.2uF | Capacitor_SMD:C_1206_3216Metric | 0.68 | https://www.tme.eu/pl/details/cl31b225kbhnnne/kondensatory-mlcc-smd-1206/samsung/ | CL31B225KBHNNNE |  | SAMSUNG | SMD
C55 C57 C56 C58 | 4 | 10uF | Capacitor_SMD:C_1206_3216Metric | 0.27 |  | CL31B106KAHNNNE |  | SAMSUNG | SMD
C3 C17 | 2 | 1uF | Capacitor_SMD:C_0805_2012Metric | 0.09 |  | CL21B105KBFNNNE |  | SAMSUNG | SMD
C36 | 1 | 1uF | Capacitor_SMD:C_0603_1608Metric | 0.09 |  | CL21B105KBFNNNE |  | SAMSUNG | SMD
C5 C6 C8 C10 C4 C19 C20 C22 C24 C18 C31 C37 C38 C39 C40 C41 C42 C35 C34 C48 C54 C63 C68 | 23 | 0.1uF | Capacitor_SMD:C_0603_1608Metric | 0.06 |  | CL10B104KB8NNNC |  | SAMSUNG | SMD
C47 C45 C46 C43 C44 C53 C60 C61 C62 C66 C67 C64 C65 | 13 | 1nF | Capacitor_SMD:C_0603_1608Metric | 0.06 | https://www.tme.eu/pl/details/cl10b102kb8nnnc/kondensatory-mlcc-smd-0603/samsung/ | CL10B102KB8NNNC | Kondensator: ceramiczny; MLCC; 1nF; 50V; X7R; Â±10%; SMD; 0603 | SAMSUNG | SMD
C9 C23 C33 C32 | 4 | 2.2uF | Capacitor_SMD:C_0603_1608Metric | 0.08 | https://www.tme.eu/pl/details/cl10a225kp8nnnc/kondensatory-mlcc-smd-0603/samsung/ | CL10A225KP8NNNC |  | SAMSUNG | SMD
C7 C21 C52 | 3 | 22nF | Capacitor_SMD:C_0603_1608Metric | 0.07 | https://www.tme.eu/pl/details/cc0603krx7r9223/kondensatory-mlcc-smd-0603/yageo/cc0603krx7r9bb223/ | CC0603KRX7R9223 |  | YAGEO | SMD
C14 C11 C12 C13 C28 C25 C26 C27 | 8 | 470pF | Capacitor_SMD:C_0805_2012Metric | 0.09 | https://www.tme.eu/pl/details/c0805c471j1gac/kondensatory-mlcc-smd-0805/kemet/c0805c471j1gactu/ | C0805C471J1GAC |  | KEMET | SMD
C30 C29 | 2 | 20pF | Capacitor_SMD:C_0603_1608Metric | 0.15 | https://www.tme.eu/pl/details/c0603c200j5gac/kondensatory-mlcc-smd-0603/kemet/c0603c200j5gactu/ | C0603C200J5GAC |  | KEMET | SMD
FB1 FB2 FB3 FB4 FB5 FB6 FB7 FB8 | 8 | 60Ohm@100MHz | Inductor_SMD:L_0805_2012Metric | 0.14 | https://www.tme.eu/pl/details/blm21pg600sn1d/ferryty-koraliki/murata/ | BLM21PG600SN1D | Ferryt: koralik; Imp.@ 100MHz: 60Î©; MontaĹĽ: SMD; 3A; Obud: 0805 | MURATA | SMD
FB10 FB9 | 2 | 1000@100MHz | Inductor_SMD:L_0805_2012Metric | 0.28 | https://www.tme.eu/pl/details/blm21ag102sn1d/ferryty-koraliki/murata/ | BLM21AG102SN1D | Ferryt: koralik; Imp.@ 100MHz: 1000Î©; MontaĹĽ: SMD; 0,5A; Obud: 0805 | MURATA | SMD
Q1 Q2 Q3 Q5 Q6 Q7 Q8 Q9 | 8 | BC817 | Package_TO_SOT_SMD:SOT-23 | 0.12 | https://www.tme.eu/pl/details/bc817.215/tranzystory-npn-smd/nexperia/ | BC817.215 | Tranzystor: NPN; bipolarny; 45V; 0,5A; 250mW; SOT23 | NEXPERIA | SMD
J25 | 1 | SPI Interface | Connector_JST:JST_PH_B5B-PH-K_1x05_P2.00mm_Vertical | 0.91 | https://www.tme.eu/pl/details/b5b-ph-k-s/zlacza-sygnalowe-raster-2-00mm/jst/ | B5B-PH-K-S | Gniazdo; przewĂłd-pĹ‚ytka; mÄ™skie; PH; 2mm; PIN: 5; THT; 100V; 2A | JST | THT
J1 | 1 | Motor Y | Connector_JST:JST_XH_B4B-XH-AM_1x04_P2.50mm_Vertical | 0.82 | https://www.tme.eu/pl/details/b4b-xh-a/zlacza-sygnalowe-raster-2-50mm/jst/ | B4B-XH-A | Gniazdo; przewĂłd-pĹ‚ytka; mÄ™skie; XH; 2,5mm; PIN: 4; THT; 250V; 3A | JST | THT
J2 | 1 | Motor Z | Connector_JST:JST_XH_B4B-XH-AM_1x04_P2.50mm_Vertical | 0.82 | https://www.tme.eu/pl/details/b4b-xh-a/zlacza-sygnalowe-raster-2-50mm/jst/ | B4B-XH-A | Gniazdo; przewĂłd-pĹ‚ytka; mÄ™skie; XH; 2,5mm; PIN: 4; THT; 250V; 3A | JST | THT
J26 | 1 | I2C Interface | Connector_JST:JST_PH_B4B-PH-K_1x04_P2.00mm_Vertical | 0.78 | https://www.tme.eu/pl/details/b4b-ph-k-s/zlacza-sygnalowe-raster-2-00mm/jst/ | B4B-PH-K-S | Gniazdo; przewĂłd-pĹ‚ytka; mÄ™skie; PH; 2mm; PIN: 4; THT; 100V; 2A | JST | THT
J13 | 1 | LED 1 | Connector_JST:JST_PH_B3B-PH-K_1x03_P2.00mm_Vertical | 0.60 | https://www.tme.eu/pl/details/b3b-ph-k-s/zlacza-sygnalowe-raster-2-00mm/jst/ | B3B-PH-K-S | Gniazdo; przewĂłd-pĹ‚ytka; mÄ™skie; PH; 2mm; PIN: 3; THT; 100V; 2A | JST | THT
J14 | 1 | LED 2 | Connector_JST:JST_PH_B3B-PH-K_1x03_P2.00mm_Vertical | 0.60 | https://www.tme.eu/pl/details/b3b-ph-k-s/zlacza-sygnalowe-raster-2-00mm/jst/ | B3B-PH-K-S | Gniazdo; przewĂłd-pĹ‚ytka; mÄ™skie; PH; 2mm; PIN: 3; THT; 100V; 2A | JST | THT
J15 | 1 | Y AXIS | Connector_JST:JST_PH_B3B-PH-K_1x03_P2.00mm_Vertical | 0.60 | https://www.tme.eu/pl/details/b3b-ph-k-s/zlacza-sygnalowe-raster-2-00mm/jst/ | B3B-PH-K-S | Gniazdo; przewĂłd-pĹ‚ytka; mÄ™skie; PH; 2mm; PIN: 3; THT; 100V; 2A | JST | THT
J16 | 1 | Z AXIS | Connector_JST:JST_PH_B3B-PH-K_1x03_P2.00mm_Vertical | 0.60 | https://www.tme.eu/pl/details/b3b-ph-k-s/zlacza-sygnalowe-raster-2-00mm/jst/ | B3B-PH-K-S | Gniazdo; przewĂłd-pĹ‚ytka; mÄ™skie; PH; 2mm; PIN: 3; THT; 100V; 2A | JST | THT
J18 | 1 | TABLE SENSOR | Connector_JST:JST_PH_B3B-PH-K_1x03_P2.00mm_Vertical | 0.60 | https://www.tme.eu/pl/details/b3b-ph-k-s/zlacza-sygnalowe-raster-2-00mm/jst/ | B3B-PH-K-S | Gniazdo; przewĂłd-pĹ‚ytka; mÄ™skie; PH; 2mm; PIN: 3; THT; 100V; 2A | JST | THT
J20 | 1 | PHOTO SENSOR RECEIVER | Connector_JST:JST_PH_B3B-PH-K_1x03_P2.00mm_Vertical | 0.60 | https://www.tme.eu/pl/details/b3b-ph-k-s/zlacza-sygnalowe-raster-2-00mm/jst/ | B3B-PH-K-S | Gniazdo; przewĂłd-pĹ‚ytka; mÄ™skie; PH; 2mm; PIN: 3; THT; 100V; 2A | JST | THT
J22 | 1 | EPSON POWER IN | Connector_JST:JST_PH_B3B-PH-K_1x03_P2.00mm_Vertical | 0.60 | https://www.tme.eu/pl/details/b3b-ph-k-s/zlacza-sygnalowe-raster-2-00mm/jst/ | B3B-PH-K-S | Gniazdo; przewĂłd-pĹ‚ytka; mÄ™skie; PH; 2mm; PIN: 3; THT; 100V; 2A | JST | THT
J23 | 1 | EPSON BOARD POWER | Connector_JST:JST_PH_B3B-PH-K_1x03_P2.00mm_Vertical | 0.60 | https://www.tme.eu/pl/details/b3b-ph-k-s/zlacza-sygnalowe-raster-2-00mm/jst/ | B3B-PH-K-S | Gniazdo; przewĂłd-pĹ‚ytka; mÄ™skie; PH; 2mm; PIN: 3; THT; 100V; 2A | JST | THT
J5 | 1 | DEBUG | Connector_JST:JST_PH_B3B-PH-K_1x03_P2.00mm_Vertical | 0.60 | https://www.tme.eu/pl/details/b3b-ph-k-s/zlacza-sygnalowe-raster-2-00mm/jst/ | B3B-PH-K-S | Gniazdo; przewĂłd-pĹ‚ytka; mÄ™skie; PH; 2mm; PIN: 3; THT; 100V; 2A | JST | THT
J17 | 1 | Power Input | Connector_JST:JST_XH_B2B-XH-AM_1x02_P2.50mm_Vertical | 0.49 | https://www.tme.eu/pl/details/b2b-xh-a/zlacza-sygnalowe-raster-2-50mm/jst/ | B2B-XH-A | Gniazdo; przewĂłd-pĹ‚ytka; mÄ™skie; XH; 2,5mm; PIN: 2; THT; 250V; 3A | JST | THT
J12 | 1 | WASTE INK | Connector_JST:JST_PH_B2B-PH-K_1x02_P2.00mm_Vertical | 0.47 | https://www.tme.eu/pl/details/b2b-ph-k-s/zlacza-sygnalowe-raster-2-00mm/jst/ | B2B-PH-K-S | Gniazdo; przewĂłd-pĹ‚ytka; mÄ™skie; PH; 2mm; PIN: 2; THT; 100V; 2A | JST | THT
J19 | 1 | PHOTO SENSOR EMITER | Connector_JST:JST_PH_B2B-PH-K_1x02_P2.00mm_Vertical | 0.47 | https://www.tme.eu/pl/details/b2b-ph-k-s/zlacza-sygnalowe-raster-2-00mm/jst/ | B2B-PH-K-S | Gniazdo; przewĂłd-pĹ‚ytka; mÄ™skie; PH; 2mm; PIN: 2; THT; 100V; 2A | JST | THT
J21 | 1 | EMERGENCY | Connector_JST:JST_PH_B2B-PH-K_1x02_P2.00mm_Vertical | 0.47 | https://www.tme.eu/pl/details/b2b-ph-k-s/zlacza-sygnalowe-raster-2-00mm/jst/ | B2B-PH-K-S | Gniazdo; przewĂłd-pĹ‚ytka; mÄ™skie; PH; 2mm; PIN: 2; THT; 100V; 2A | JST | THT
J27 | 1 | LED3 | Connector_JST:JST_PH_B2B-PH-K_1x02_P2.00mm_Vertical | 0.47 | https://www.tme.eu/pl/details/b2b-ph-k-s/zlacza-sygnalowe-raster-2-00mm/jst/ | B2B-PH-K-S | Gniazdo; przewĂłd-pĹ‚ytka; mÄ™skie; PH; 2mm; PIN: 2; THT; 100V; 2A | JST | THT
J28 | 1 | LED4 | Connector_JST:JST_PH_B2B-PH-K_1x02_P2.00mm_Vertical | 0.47 | https://www.tme.eu/pl/details/b2b-ph-k-s/zlacza-sygnalowe-raster-2-00mm/jst/ | B2B-PH-K-S | Gniazdo; przewĂłd-pĹ‚ytka; mÄ™skie; PH; 2mm; PIN: 2; THT; 100V; 2A | JST | THT
J29 | 1 | Key 3 | Connector_JST:JST_PH_B2B-PH-K_1x02_P2.00mm_Vertical | 0.47 | https://www.tme.eu/pl/details/b2b-ph-k-s/zlacza-sygnalowe-raster-2-00mm/jst/ | B2B-PH-K-S | Gniazdo; przewĂłd-pĹ‚ytka; mÄ™skie; PH; 2mm; PIN: 2; THT; 100V; 2A | JST | THT
J30 | 1 | Key 4 | Connector_JST:JST_PH_B2B-PH-K_1x02_P2.00mm_Vertical | 0.47 | https://www.tme.eu/pl/details/b2b-ph-k-s/zlacza-sygnalowe-raster-2-00mm/jst/ | B2B-PH-K-S | Gniazdo; przewĂłd-pĹ‚ytka; mÄ™skie; PH; 2mm; PIN: 2; THT; 100V; 2A | JST | THT
J31 | 1 | Key 1 | Connector_JST:JST_PH_B2B-PH-K_1x02_P2.00mm_Vertical | 0.47 | https://www.tme.eu/pl/details/b2b-ph-k-s/zlacza-sygnalowe-raster-2-00mm/jst/ | B2B-PH-K-S | Gniazdo; przewĂłd-pĹ‚ytka; mÄ™skie; PH; 2mm; PIN: 2; THT; 100V; 2A | JST | THT
J32 | 1 | Key 2 | Connector_JST:JST_PH_B2B-PH-K_1x02_P2.00mm_Vertical | 0.47 | https://www.tme.eu/pl/details/b2b-ph-k-s/zlacza-sygnalowe-raster-2-00mm/jst/ | B2B-PH-K-S | Gniazdo; przewĂłd-pĹ‚ytka; mÄ™skie; PH; 2mm; PIN: 2; THT; 100V; 2A | JST | THT
J6 | 1 | LIMIT Z UP | Connector_JST:JST_PH_B2B-PH-K_1x02_P2.00mm_Vertical | 0.47 | https://www.tme.eu/pl/details/b2b-ph-k-s/zlacza-sygnalowe-raster-2-00mm/jst/ | B2B-PH-K-S | Gniazdo; przewĂłd-pĹ‚ytka; mÄ™skie; PH; 2mm; PIN: 2; THT; 100V; 2A | JST | THT
J7 | 1 | LIMIT Z DOWN | Connector_JST:JST_PH_B2B-PH-K_1x02_P2.00mm_Vertical | 0.47 | https://www.tme.eu/pl/details/b2b-ph-k-s/zlacza-sygnalowe-raster-2-00mm/jst/ | B2B-PH-K-S | Gniazdo; przewĂłd-pĹ‚ytka; mÄ™skie; PH; 2mm; PIN: 2; THT; 100V; 2A | JST | THT
J8 | 1 | LIMIT Y BACK | Connector_JST:JST_PH_B2B-PH-K_1x02_P2.00mm_Vertical | 0.47 | https://www.tme.eu/pl/details/b2b-ph-k-s/zlacza-sygnalowe-raster-2-00mm/jst/ | B2B-PH-K-S | Gniazdo; przewĂłd-pĹ‚ytka; mÄ™skie; PH; 2mm; PIN: 2; THT; 100V; 2A | JST | THT
J9 | 1 | LIMIT Y FRONT | Connector_JST:JST_PH_B2B-PH-K_1x02_P2.00mm_Vertical | 0.47 | https://www.tme.eu/pl/details/b2b-ph-k-s/zlacza-sygnalowe-raster-2-00mm/jst/ | B2B-PH-K-S | Gniazdo; przewĂłd-pĹ‚ytka; mÄ™skie; PH; 2mm; PIN: 2; THT; 100V; 2A | JST | THT
D24 | 1 | B140-13-F | Diode_SMD:D_SMA | 0.29 | https://www.tme.eu/pl/details/b140-13-f/diody-schottky-smd/diodes-incorporated/ | B140-13-F | Dioda: prostownicza Schottky; SMD; 40V; 1A; SMA | DIODES INCORPORATED | SMD
J24 | 1 | Display | Connector_JST:JST_PH_B10B-PH-K_1x10_P2.00mm_Vertical | 1.33 | https://pl.farnell.com/jst-japan-solderless-terminals/b10b-ph-k-s-lf-sn/header-tht-vertical-2mm-10way/dp/9491880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 | B10B-PH-K-S | ZĹ‚Ä…cze przewĂłd-pĹ‚ytka, pionowe, 2 mm, 10 styki/-Ăłw, Header, Seria PH, Przewlekane, 1 rzÄ™dy/-Ăłw | JST | THT
U6 | 1 | A4403 | Package_DFN_QFN:QFN-16-1EP_4x4mm_P0.65mm_EP2.7x2.7mm | 6.66 | https://www.tme.eu/pl/details/a4403geutr-t/regulatory-napiecia-uklady-dc-dc/allegro-microsystems/ | A4403GEUTR-T | PMIC; przetwornica DC/DC; Upracy: 9Ă·46V; Uwyj: 46V; QFN16; buck | ALLEGRO | SMD
Y1 | 1 | 8MHz | Crystal:Crystal_HC49-U_Vertical | 1.64 | https://www.tme.eu/pl/details/8m-49s-sr/rezonatory-kwarcowe-tht/sr-passives/ | 8M-49S-SR | Rezonator: kwarcowy; 8MHz; Â±30ppm; 20pF; THT; HC49-S | SR PASSIVES | THT
U8 | 1 | 74HC2G32 | Package_SO:VSSOP-8_2.3x2mm_P0.5mm | 1.13 | https://www.tme.eu/pl/details/74hc2g32dc.125/bramki-inwertery/nexperia/ | 74HC2G32DC.125 | IC: cyfrowy; OR; KanaĹ‚y: 2; IN: 4; CMOS; SMD; VSSOP8; Seria: HC; 2Ă·6VDC | NEXPERIA | SMD
U5 U9 | 2 | 74HC245 | Package_SO:TSSOP-20_4.4x6.5mm_P0.65mm | 0.97 | https://www.tme.eu/pl/details/74hc245pw.112/bufory-nadajniki-sterowniki/nexperia/ | 74HC245PW.112 | IC: cyfrowy; bus transceiver; KanaĹ‚y: 8; SMD; TSSOP20; Seria: HC | NEXPERIA | SMD
R44 R43 | 2 | 100mÎ© | Resistor_SMD:R_1206_3216Metric | 0.34 | https://www.tme.eu/pl/details/smd1206-r10-lo/rezystory-smd-1206/te-connectivity/6-1622825-5/ | 6-1622825-5 | Rezystor: metal glaze; SMD; 1206; 100mÎ©; 0,25W; Â±5%; 200ppm/Â°C | TE Connectivity | SMD
RN1 RN2 RN3 RN4 | 4 | 330Î© | Resistor_SMD:R_Array_Convex_4x0603 | 0.05 | https://www.tme.eu/pl/details/dr1206-330r-4_8/drabinki-rezystorowe-smd/royal-ohm/4d03wgj0331t/ | 4D03WGJ0331T | Drabinka rezystorowa: Y; 330Î©; SMD; 1206; Il.rezystorĂłw: 4; 63mW | ROYAL OHM | SMD
J3 | 1 | USB_B | Connector_USB:USB_B_OST_USB-B1HSxx_Horizontal | 2.96 | https://www.tme.eu/pl/details/2411-02/zlacza-usb-i-ieee1394/lumberg/2411-02/ | 2411 02 | Gniazdo; USB B; na PCB; THT; PIN: 4; kÄ…towe 90Â°; V: USB 2.0; biaĹ‚y | LUMBERG | THT
D18 D26 D27 D28 D29 D30 D31 | 7 | 1N4448WS-7-F | Diode_SMD:D_SOD-323 | 0.15 | https://www.tme.eu/pl/details/1n4448ws-7-f/diody-uniwersalne-smd/diodes-incorporated/ | 1N4448WS-7-F | Dioda: prostownicza; SMD; 75V; 0,25A; 4ns; | DIODES INCORPORATED | SMD
F3 | 1 | 0ZCF0185FF2C | Fuse:Fuse_2920_7451Metric | 0.87 | https://www.tme.eu/pl/details/0zcf0185ff2c/bezpieczniki-polimerowe-smd/bel-fuse/ | 0ZCF0185FF2C | Bezpiecznik: polimerowy PTC; 1,85A; Imax: 100A; Obud: 2920; 0ZCF | BEL FUSE | SMD
R47 | 1 | 3.92kÎ© | Resistor_SMD:R_0603_1608Metric | 0.05 | https://www.tme.eu/pl/details/smd0603-3.92k-1%25/rezystory-smd-0603/royal-ohm/0603saf3921t5e/ | 0603SAF3921T5E | Rezystor: thick film; SMD; 0603; 3,92kÎ©; 0,1W; Â±1%; -55Ă·155Â°C | ROYAL OHM | SMD
R14 R13 R10 R11 R34 R46 R49 R53 R50 R54 | 10 | 10kÎ© | Resistor_SMD:R_0603_1608Metric | 0.04 | https://www.tme.eu/pl/details/smd0603-10k-1%25/rezystory-smd-0603/royal-ohm/0603saf1002t5e/ | 0603SAF1002T5E | Rezystor: thick film; SMD; 0603; 10kÎ©; 0,1W; Â±1%; -55Ă·155Â°C | ROYAL OHM | SMD
R2 R6 R32 R24 R25 R22 R23 R36 R29 R30 R40 R57 R70 R71 R68 R69 | 16 | 1kÎ© | Resistor_SMD:R_0603_1608Metric | 0.05 | https://www.tme.eu/pl/details/smd0603-1k-1%25/rezystory-smd-0603/royal-ohm/0603saf1001t5e/ | 0603SAF1001T5E | Rezystor: thick film; SMD; 0603; 1kÎ©; 0,1W; Â±1%; -55Ă·155Â°C | ROYAL OHM | SMD
C51 | 1 | 47nF | Capacitor_SMD:C_0603_1608Metric | 0.05 |  |  |  |  | SMD
C59 | 1 | 10nF | Capacitor_SMD:C_0603_1608Metric | 0.05 |  |  |  |  | SMD
FID1 FID2 FID3 FID4 | 4 | Fiducial | Fiducial:Fiducial_1mm_Mask2mm
H1 H2 H3 H4 H5 H6 | 6 | MH | MountingHole:MountingHole_3.5mm_Pad_Via
J10 | 1 | CA58SUB-B | footprints:THT_FPC_r1.0mm_11pin_vertical | 0.60
J11 | 1 | PC6 EPSON MAINBOARD | footprints:THT_FPC_r1.0mm_11pin_vertical | 0.60
R1 | 1 | 0Î© | Resistor_SMD:R_0805_2012Metric | 0.05 |  |  |  |  | SMD
R12 | 1 | 47RÎ© | Resistor_SMD:R_0603_1608Metric | 0.05 |  |  |  |  | SMD
R15 R26 R27 | 3 | 0Î© | Resistor_SMD:R_0603_1608Metric | 0.05 |  |  |  |  | SMD
R16 R17 R38 R62 R63 | 5 | 330Î© | Resistor_SMD:R_0603_1608Metric | 0.05 |  |  |  |  | SMD
R28 | 1 | NI | Resistor_SMD:R_0603_1608Metric | 0.05 |  |  |  |  | SMD
R3 R7 R41 R39 R59 R58 | 6 | 100kÎ© | Resistor_SMD:R_0603_1608Metric | 0.05 |  |  |  |  | SMD
R37 | 1 | 10kÎ© | Resistor_SMD:R_0805_2012Metric | 0.05 |  |  |  |  | SMD
R42 | 1 | 47Î© | Resistor_SMD:R_0603_1608Metric | 0.05 |  |  |  |  | SMD
R48 | 1 | 750Î© | Resistor_SMD:R_0603_1608Metric | 0.05 |  |  |  |  | SMD
R51 R52 R56 | 3 | 33kÎ© | Resistor_SMD:R_0603_1608Metric | 0.05 |  |  |  |  | SMD
R55 | 1 | 1kÎ© | Resistor_SMD:R_0805_2012Metric | 0.05 |  |  |  |  | SMD
R73 R72 | 2 | 2.2kÎ© | Resistor_SMD:R_0603_1608Metric | 0.05 |  |  |  |  | SMD
TP1 TP5 | 2 | Z_OB2 | TestPoint:TestPoint_Pad_D1.5mm
TP2 TP6 | 2 | Z_OB1 | TestPoint:TestPoint_Pad_D1.5mm
TP3 TP7 | 2 | Z_OA2 | TestPoint:TestPoint_Pad_D1.5mm
TP4 TP8 | 2 | Z_OA1 | TestPoint:TestPoint_Pad_D1.5mm
Razem | 268 |  |  | 95.027

Sheet: Old
Oznaczenie | Producent | Model | Obudowa | Montaż | Opis | Ilość | Cena jednostkowa | Cena całkowita | Link
FB?-FB? | MURATA | BLM21PG600SN1D | SMD805 | SMT | Ferryt: koralik; Imp.@ 100MHz: 60Ω; Montaż: SMD; 3A; Obud: 0805 | 8 | 0.13718 | 1.09744 | https://www.tme.eu/pl/details/blm21pg600sn1d/ferryty-koraliki/murata/
D?-D? | DIOTEC SEMICONDUCTOR | SK25 | DO213AA | SMT | Dioda: prostownicza Schottky; SMD; 50V; 2A; SMB | 8 | 0.2445 | 1.956 | https://www.tme.eu/pl/details/sk25-dio/diody-schottky-smd/diotec-semiconductor/sk25/
D? | DIOTEC SEMICONDUCTOR | SK35SMA | SMA | SMT | Dioda: prostownicza Schottky; SMD; 50V; 3A; SMA | 1 | 0.3496 | 0.3496 | https://www.tme.eu/pl/details/sk35sma-dio/diody-schottky-smd/diotec-semiconductor/sk35sma/
U? | ALLEGRO | A4403GEUTR-T | QFN16 | SMT | PMIC; przetwornica DC/DC; Upracy: 9÷46V; Uwyj: 46V; QFN16; buck | 1 | 6.68 | 6.68 | https://www.tme.eu/pl/details/a4403geutr-t/regulatory-napiecia-uklady-dc-dc/allegro-microsystems/
L? | FERROCORE | DJNR6045-6R3-S |  | SMT | Dławik: drutowy; SMD; 6,3uH; Ipracy: 3A; 36mΩ; 6x6x4,5mm; ±20% | 1 | 0.7064 | 0.7064 | https://www.tme.eu/pl/details/djnr6045-6r3-s/dlawiki-smd-mocy/ferrocore/
U? | TRINAMIC | TMC2209-LA-T | QFN28 | SMT | Sterownik/kontroler silnika krokowego, 4.75V do 29V, 2A/1 wyjście, QFN-28 | 2 | 12.36 | 24.72 | https://pl.farnell.com/trinamic/tmc2209-la-t/motor-driver-stepper-qfn-28/dp/3131535?st=tmc2209
L? | FERROCORE | DJNR6045-150 |  | SMT | Dławik: drutowy; SMD; 15uH; Ipracy: 2,3A; 100,1mΩ; 6x5,9x4,5mm; ±20% | 1 | 0.6992 | 0.6992 | https://www.tme.eu/pl/details/djnr6045-150/dlawiki-smd-mocy/ferrocore/
U? | MICROCHIP TECHNOLOGY | MCP16301T-I/CHY | SOT23-6 | SMT | PMIC; przetwornica DC/DC; Upracy: 4÷30V; Uwyj: 2÷15V; SOT23-6; buck | 1 | 3.84 | 3.84 | https://www.tme.eu/pl/details/mcp16301t-i_chy/regulatory-napiecia-uklady-dc-dc/microchip-technology/
D? | DIODES INCORPORATED | 1N4448WS-7-F | SOD323 | SMT | Dioda: prostownicza; SMD; 75V; 0,25A; 4ns; | 1 | 0.14905 | 0.14905 | https://www.tme.eu/pl/details/1n4448ws-7-f/diody-uniwersalne-smd/diodes-incorporated/
D? | DIODES INCORPORATED | B140-13-F | SMA | SMT | Dioda: prostownicza Schottky; SMD; 40V; 1A; SMA | 1 | 0.2938 | 0.2938 | https://www.tme.eu/pl/details/b140-13-f/diody-schottky-smd/diodes-incorporated/
Q? | YANGJIE TECHNOLOGY | YJS9435A | SOP-8 | SMT | Tranzystor: P-MOSFET; TRENCH POWER LV; unipolarny; -30V; -4,1A | 1 | 0.29622 | 0.29622 | https://www.tme.eu/pl/details/yjs9435a-yan/tranzystory-z-kanalem-p-smd/yangjie-technology/yjs9435a/
D? | DIODES INCORPORATED | MMSZ5240B-7-F | SOD123 | SMT | Dioda: Zenera; 0,37/0,5W; 10V; SMD; rolka,taśma; SOD123 | 1 | 0.10646 | 0.10646 | https://www.tme.eu/pl/details/mmsz5240b-7-f/diody-zenera-smd/diodes-incorporated/
 | YANGJIE TECHNOLOGY | P4SMA30CA | SMA | SMT | Dioda: transil; 400W; 30V; 9,6A; dwukierunkowa; ±5% | 1 | 0.60763 | 0.60763 | https://www.tme.eu/pl/details/p4sma30ca-yan/diody-transil-smd-dwukierunkowe/yangjie-technology/p4sma30ca/
U? | NEXPERIA | 74HC2G32DC.125 | VSSOP8 | SMT | IC: cyfrowy; OR; Kanały: 2; IN: 4; CMOS; SMD; VSSOP8; Seria: HC; 2÷6VDC | 1 | 1.1311 | 1.1311 | https://www.tme.eu/pl/details/74hc2g32dc.125/bramki-inwertery/nexperia/
 |  | BC817 |  |  |  |  |  | 0
 |  | S13-24V-2C |  |  |  |  |  | 0
 | STM | USBUF02W6 | SOT323-6L | SMT | Filtr: cyfrowy; line terminator; EMI,dolnoprzepustowy; SOT323-6L | 1 | 1.0642 | 1.0642 | https://www.tme.eu/pl/details/usbuf02w6/filtry-uklady-scalone/stmicroelectronics/
 |  |  |  |  |  | Razem |  | 43.6971
