awojak/P600-Main-Board/Main Board.kicad_pcb

## KiCad design Main Board.kicad_pcb (2020-02-03)

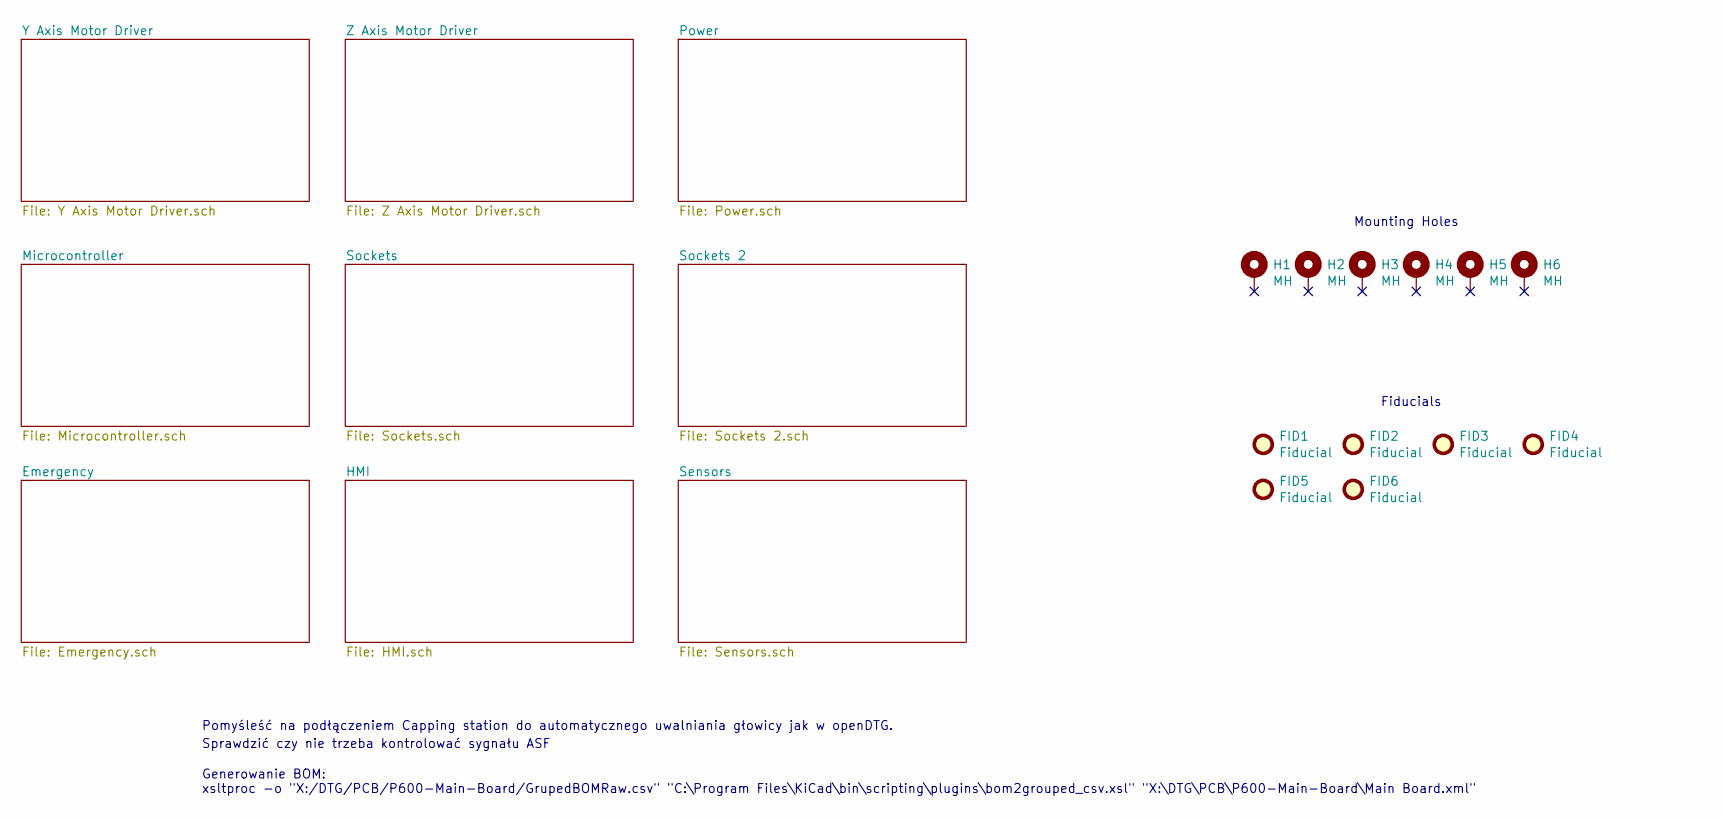
[picture p1: schematic Main Board.sch]

Parts:
FID1, FID2, FID3, FID4, FID5, FID6: Fiducial; Fiducial_1mm_Mask2mm
H1, H2, H3, H4, H5, H6: MH; MountingHole_3.5mm_Pad_Via

Notes on the sheet:
Pomyśleść na podłączeniem Capping station do automatycznego uwalniania głowicy jak w openDTG.
Sprawdzić czy nie trzeba kontrolować sygnału ASF
Mounting Holes
Fiducials
Generowanie BOM: xsltproc -o "X:/DTG/PCB/P600-Main-Board/GrupedBOMRaw.csv" "C:\Program Files\KiCad\bin\scripting\plugins\bom2grouped_csv.xsl" "X:\DTG\PCB\P600-Main-Board\Main Board.xml"

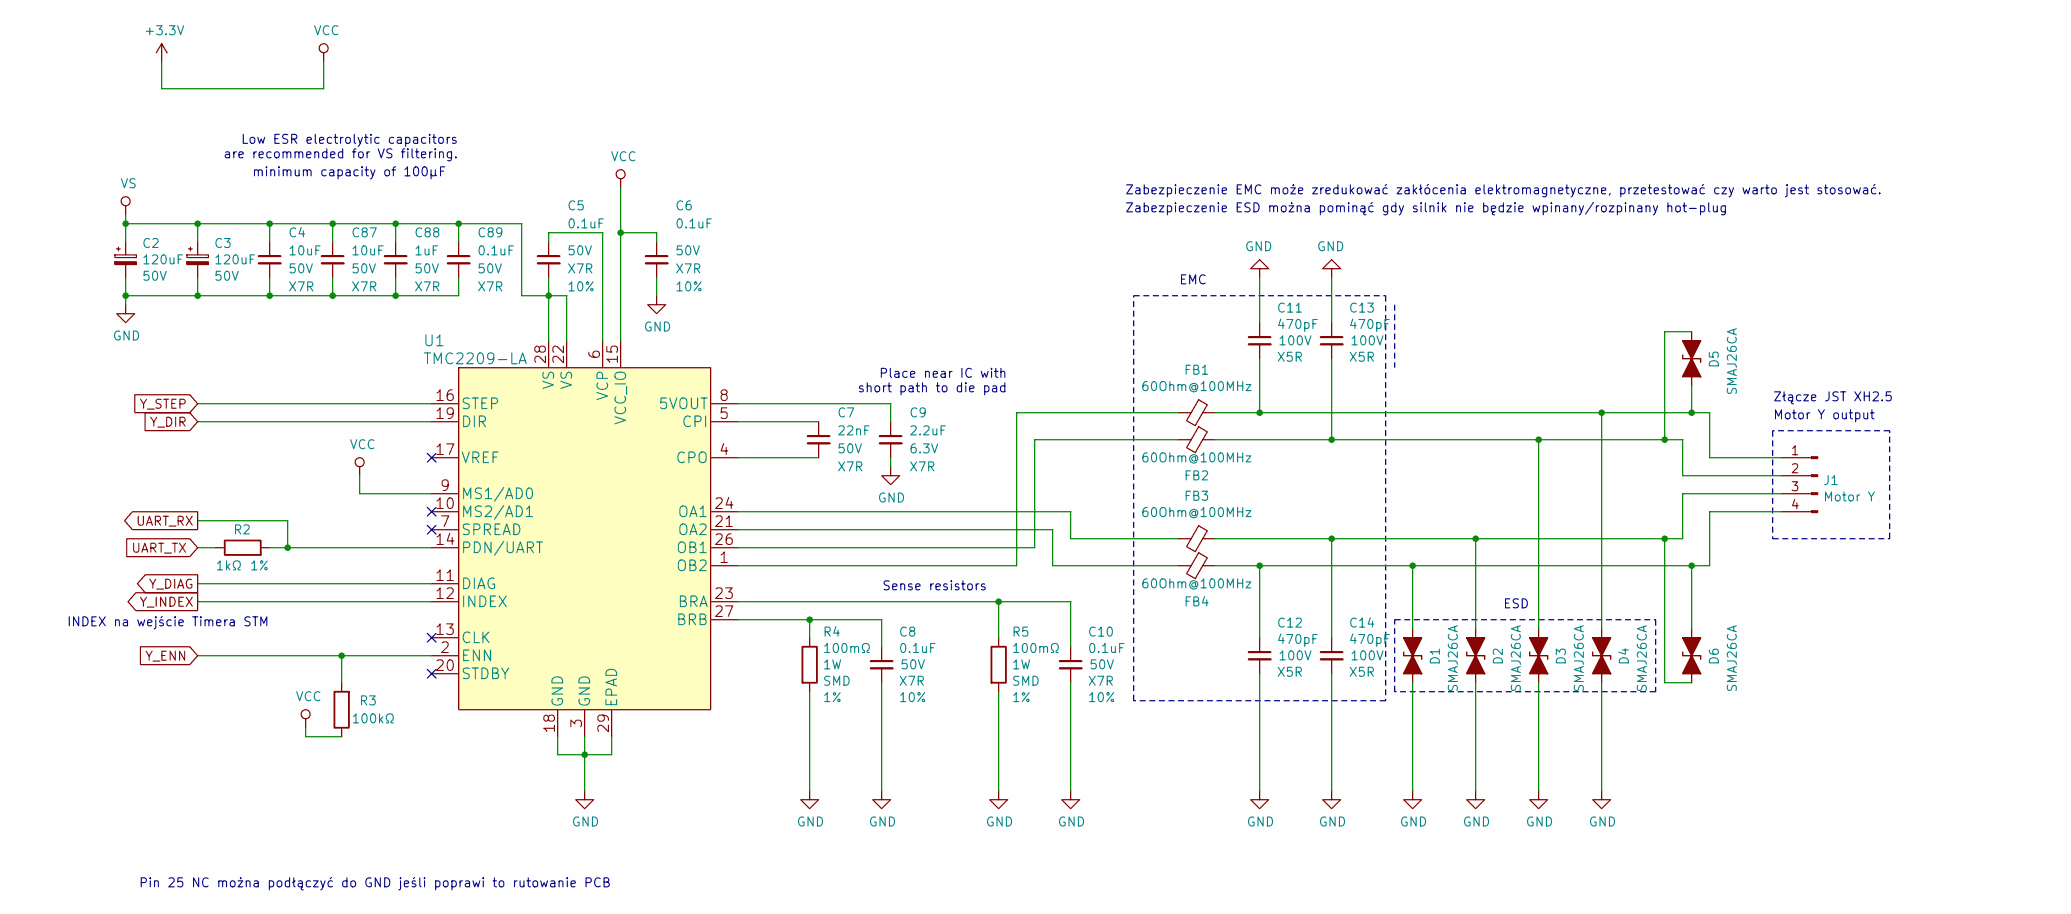
[picture p2: schematic Y Axis Motor Driver.sch]

Parts:
C2, C3: 120uF; CP_Radial_D8.0mm_P3.50mm; Tolerancja 20%
C4, C87: 10uF; C_1210_3225Metric; Tolerancja 10%
C5, C6, C8, C10, C89: 0.1uF; C_0603_1608Metric; Tolerancja 10%
C7: 22nF; C_0603_1608Metric; Tolerancja 10%
C9: 2.2uF; C_0603_1608Metric
C11, C12, C13, C14: 470pF; C_0805_2012Metric
C88: 1uF; C_0805_2012Metric; Tolerancja 10%
D1, D2, D3, D4, D5, D6: SMAJ26CA; D_SMA
FB1, FB2, FB3, FB4: 60Ohm@100MHz; L_0805_2012Metric
J1: Motor Y; JST_XH_B4B-XH-AM_1x04_P2.50mm_Vertical
R2: 1kΩ; R_0603_1608Metric; Tolerancja 1%
R3: 100kΩ; R_0603_1608Metric
R4, R5: 100mΩ; R_2010_5025Metric; Tolerancja 1%
U1: TMC2209-LA; QFN-28_5X5mm_P0.5mm_EP3.35x.3.35mm

Connections:
+3V3: C6.1, R3.1, U1.9 (MS1/AD0), U1.15 (VCC_IO); also elsewhere on the board
GND: C2.2, C3.2, C4.2, C6.2, C8.2, C9.2, C10.2, C11.1, C12.2, C13.1, C14.2, C87.2, C88.2, C89.2, D1.2 (A2), D2.2 (A2), D3.2 (A2), D4.2 (A2), R4.2, R5.2, U1.3 (GND), U1.18 (GND), U1.29 (EPAD); also elsewhere on the board
unnamed: C5.1, U1.6 (VCP)
unnamed: C7.1, U1.5 (CPI)
unnamed: C7.2, U1.4 (CPO)
unnamed: C8.1, R4.1, U1.27 (BRB)
unnamed: C9.1, U1.8 (5VOUT)
unnamed: C10.1, R5.1, U1.23 (BRA)
unnamed: C11.2, D4.1 (A1), D5.2 (A2), FB1.1, J1.1
unnamed: C12.1, D1.1 (A1), D6.1 (A1), FB4.1, J1.4
unnamed: C13.2, D3.1 (A1), D5.1 (A1), FB2.1, J1.2
unnamed: C14.1, D2.1 (A1), D6.2 (A2), FB3.1, J1.3
unnamed: FB1.2, U1.1 (OB2)
unnamed: FB2.2, U1.26 (OB1)
unnamed: FB3.2, U1.24 (OA1)
unnamed: FB4.2, U1.21 (OA2)
UART_RX: R2.2, U1.14 (PDN/UART); also elsewhere on the board
UART_TX: R2.1; also elsewhere on the board
VS: C2.1, C3.1, C4.1, C5.2, C87.1, C88.1, C89.1, U1.22 (VS), U1.28 (VS); also elsewhere on the board
Y_DIAG: U1.11 (DIAG); also elsewhere on the board
Y_DIR: U1.19 (DIR); also elsewhere on the board
Y_ENN: R3.2, U1.2 (ENN); also elsewhere on the board
Y_INDEX: U1.12 (INDEX); also elsewhere on the board
Y_STEP: U1.16 (STEP); also elsewhere on the board

Notes on the sheet:
Sense resistors
minimum capacity of 100μF
EMC
Motor Y output
Złącze JST XH2.5
Zabezpieczenie ESD można pominąć gdy silnik nie będzie wpinany/rozpinany hot-plug
Zabezpieczenie EMC może zredukować zakłócenia elektromagnetyczne, przetestować czy warto jest stosować.
Place near IC with short path to die pad
Low ESR electrolytic capacitors are recommended for VS filtering.
INDEX na wejście Timera STM
Pin 25 NC można podłączyć do GND jeśli poprawi to rutowanie PCB
ESD

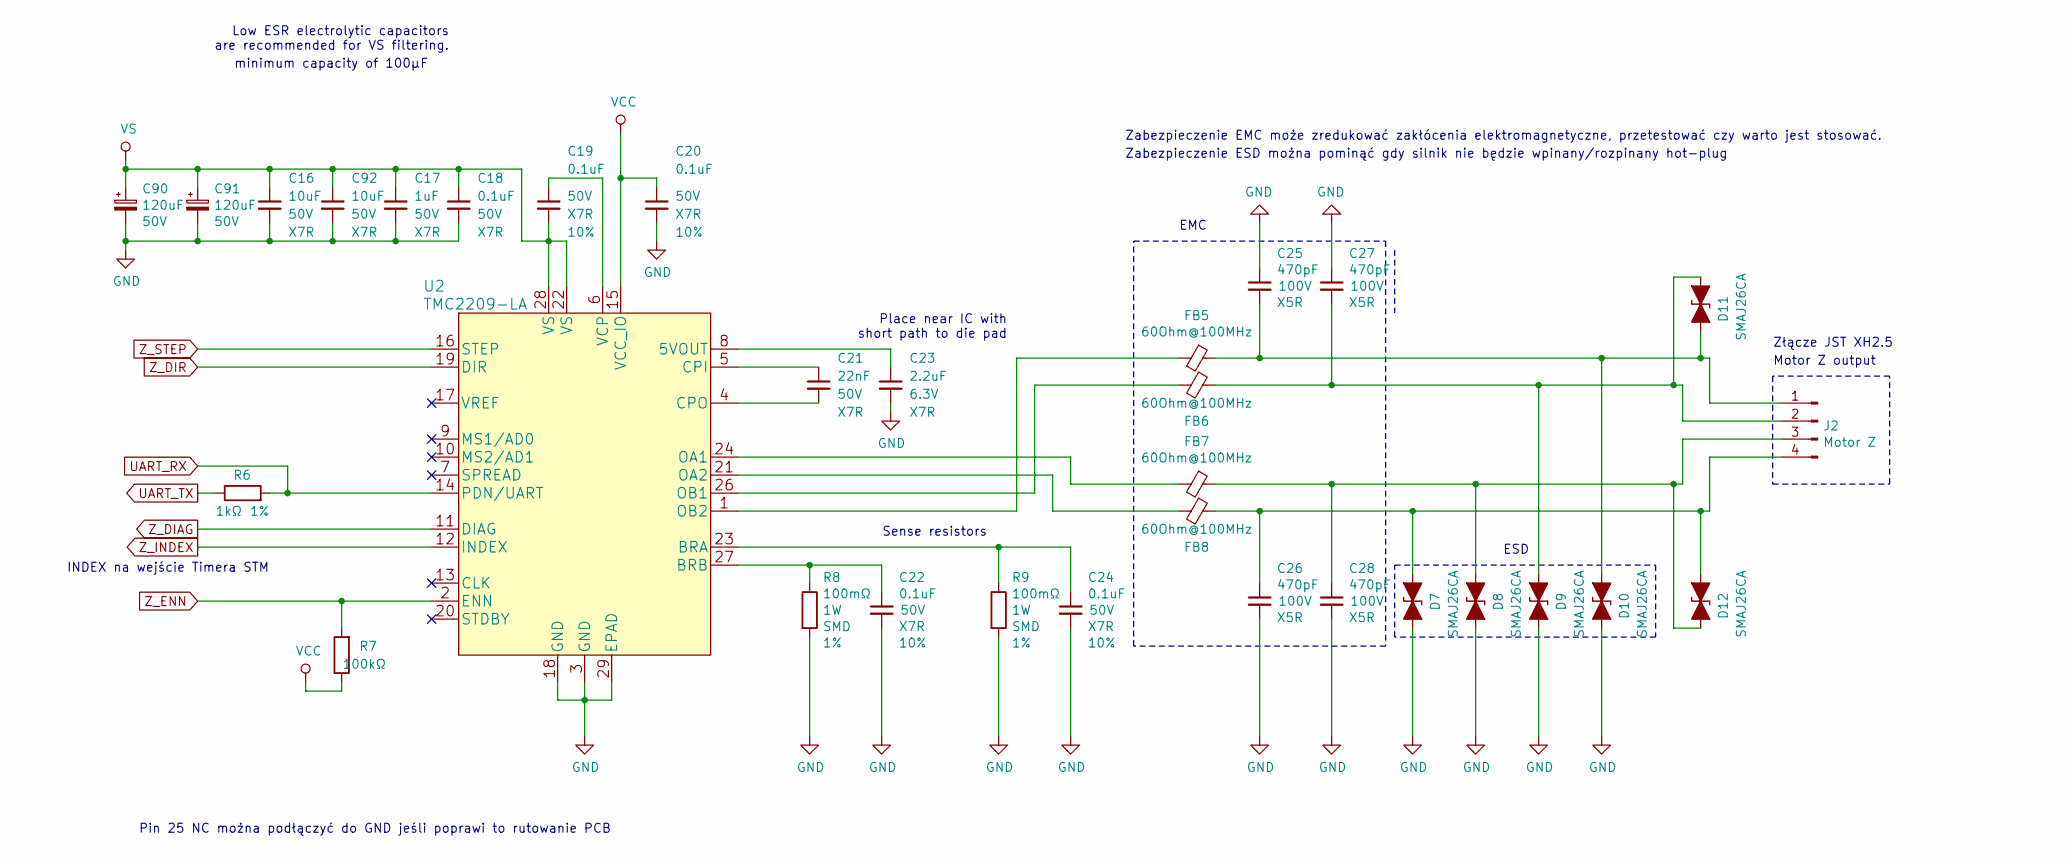
[picture p3: schematic Z Axis Motor Driver.sch]

Parts:
C16, C92: 10uF; C_1210_3225Metric; Tolerancja 10%
C17: 1uF; C_0805_2012Metric; Tolerancja 10%
C18, C19, C20, C22, C24: 0.1uF; C_0603_1608Metric; Tolerancja 10%
C21: 22nF; C_0603_1608Metric; Tolerancja 10%
C23: 2.2uF; C_0603_1608Metric
C25, C26, C27, C28: 470pF; C_0805_2012Metric
C90, C91: 120uF; CP_Radial_D8.0mm_P3.50mm; Tolerancja 20%
D7, D8, D9, D10, D11, D12: SMAJ26CA; D_SMA
FB5, FB6, FB7, FB8: 60Ohm@100MHz; L_0805_2012Metric
J2: Motor Z; JST_XH_B4B-XH-AM_1x04_P2.50mm_Vertical
R6: 1kΩ; R_0603_1608Metric; Tolerancja 1%
R7: 100kΩ; R_0603_1608Metric
R8, R9: 100mΩ; R_2010_5025Metric; Tolerancja 1%
U2: TMC2209-LA; QFN-28_5X5mm_P0.5mm_EP3.35x.3.35mm

Connections:
+3V3: C20.1, R7.1, U2.15 (VCC_IO); also elsewhere on the board
GND: C16.2, C17.2, C18.2, C20.2, C22.2, C23.2, C24.2, C25.1, C26.2, C27.1, C28.2, C90.2, C91.2, C92.2, D7.2 (A2), D8.2 (A2), D9.2 (A2), D10.2 (A2), R8.2, R9.2, U2.3 (GND), U2.18 (GND), U2.29 (EPAD); also elsewhere on the board
unnamed: C19.1, U2.6 (VCP)
unnamed: C21.1, U2.5 (CPI)
unnamed: C21.2, U2.4 (CPO)
unnamed: C22.1, R8.1, U2.27 (BRB)
unnamed: C23.1, U2.8 (5VOUT)
unnamed: C24.1, R9.1, U2.23 (BRA)
unnamed: C25.2, D10.1 (A1), D11.2 (A2), FB5.1, J2.1
unnamed: C26.1, D7.1 (A1), D12.1 (A1), FB8.1, J2.4
unnamed: C27.2, D9.1 (A1), D11.1 (A1), FB6.1, J2.2
unnamed: C28.1, D8.1 (A1), D12.2 (A2), FB7.1, J2.3
unnamed: FB5.2, U2.1 (OB2)
unnamed: FB6.2, U2.26 (OB1)
unnamed: FB7.2, U2.24 (OA1)
unnamed: FB8.2, U2.21 (OA2)
UART_RX: R6.2, U2.14 (PDN/UART); also elsewhere on the board
UART_TX: R6.1; also elsewhere on the board
VS: C16.1, C17.1, C18.1, C19.2, C90.1, C91.1, C92.1, U2.22 (VS), U2.28 (VS); also elsewhere on the board
Z_DIAG: U2.11 (DIAG); also elsewhere on the board
Z_DIR: U2.19 (DIR); also elsewhere on the board
Z_ENN: R7.2, U2.2 (ENN); also elsewhere on the board
Z_INDEX: U2.12 (INDEX); also elsewhere on the board
Z_STEP: U2.16 (STEP); also elsewhere on the board

Notes on the sheet:
Sense resistors
minimum capacity of 100μF
EMC
Motor Z output
Złącze JST XH2.5
Zabezpieczenie ESD można pominąć gdy silnik nie będzie wpinany/rozpinany hot-plug
Zabezpieczenie EMC może zredukować zakłócenia elektromagnetyczne, przetestować czy warto jest stosować.
Place near IC with short path to die pad
Low ESR electrolytic capacitors are recommended for VS filtering.
INDEX na wejście Timera STM
Pin 25 NC można podłączyć do GND jeśli poprawi to rutowanie PCB
ESD

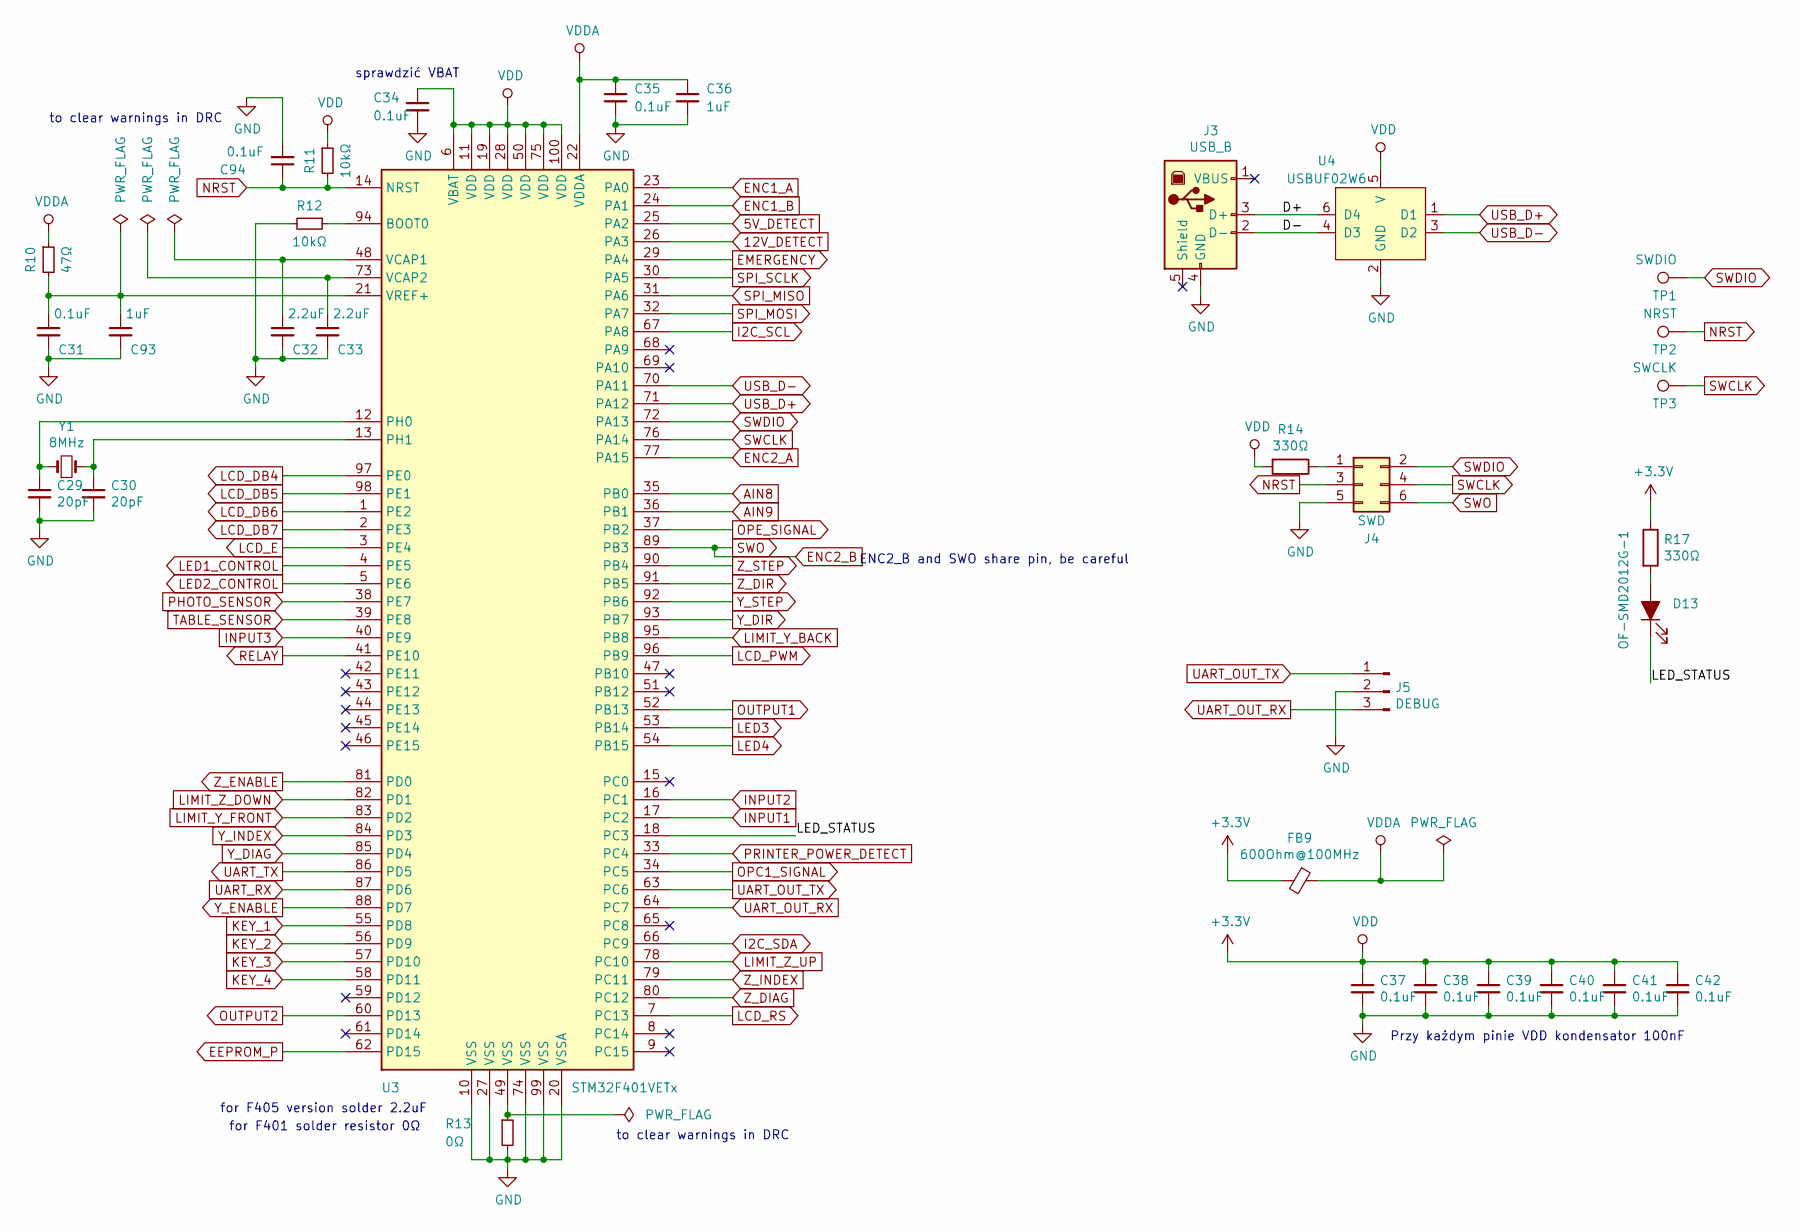
[picture p4: schematic Microcontroller.sch]

Parts:
C29, C30: 20pF; C_0603_1608Metric
C31, C34, C35, C37, C38, C39, C40, C41, C42, C94: 0.1uF; C_0603_1608Metric; Tolerancja 10%
C32, C33: 2.2uF; C_0603_1608Metric
C36: 1uF; C_0603_1608Metric; Tolerancja 10%
C93: 1uF; C_0603_1608Metric
D13: OF-SMD2012G-1; D_0805_2012Metric
FB9: 600Ohm@100MHz; L_0603_1608Metric
J3: USB_B; USB_B_TE_5787834_Vertical
J4: SWD; Tag-Connect_TC2030-IDC-NL_2x03_P1.27mm_Vertical
J5: DEBUG; JST_PH_B3B-PH-K_1x03_P2.00mm_Vertical
R10: 47Ω; R_0603_1608Metric
R11, R12: 10kΩ; R_0603_1608Metric
R13: 0Ω; R_0603_1608Metric
R14, R17: 330Ω; R_0603_1608Metric
TP1: SWDIO; TestPoint_Pad_D1.5mm
TP2: NRST; TestPoint_Pad_D1.5mm
TP3: SWCLK; TestPoint_Pad_D1.5mm
U3: STM32F401VETx; LQFP-100_14x14mm_P0.5mm
U4: USBUF02W6; SOT323-6L
Y1: 8MHz; Crystal_HC49-4H_Vertical

Connections:
5V_DETECT: U3.25 (PA2); also elsewhere on the board
12V_DETECT: U3.26 (PA3); also elsewhere on the board
+3V3: C34.1, C37.1, C38.1, C39.1, C40.1, C41.1, C42.1, FB9.2, R11.1, R14.2, R17.1, U3.6 (VBAT), U3.11 (VDD), U3.19 (VDD), U3.28 (VDD), U3.50 (VDD), U3.75 (VDD), U3.100 (VDD), U4.5 (V); also elsewhere on the board
/Microcontroller/D+: J3.3 (D+), U4.6 (D4)
/Microcontroller/D-: J3.2 (D-), U4.4 (D3)
/Microcontroller/LED_STATUS: D13.1 (K), U3.18 (PC3)
AIN8: U3.35 (PB0); also elsewhere on the board
AIN9: U3.36 (PB1); also elsewhere on the board
EEPROM_P: U3.62 (PD15); also elsewhere on the board
EMERGENCY: U3.29 (PA4); also elsewhere on the board
ENC1_A: U3.23 (PA0); also elsewhere on the board
ENC1_B: U3.24 (PA1); also elsewhere on the board
ENC2_A: U3.77 (PA15); also elsewhere on the board
ENC2_B: J4.6, U3.89 (PB3); also elsewhere on the board
GND: C29.2, C30.2, C31.2, C32.2, C33.2, C34.2, C35.2, C36.2, C37.2, C38.2, C39.2, C40.2, C41.2, C42.2, C93.2, C94.2, J3.4 (GND), J4.5, J5.2, R12.2, R13.2, U3.10 (VSS), U3.20 (VSSA), U3.27 (VSS), U3.74 (VSS), U3.99 (VSS), U4.2 (GND); also elsewhere on the board
I2C_SCL: U3.67 (PA8); also elsewhere on the board
I2C_SDA: U3.66 (PC9); also elsewhere on the board
INPUT1: U3.17 (PC2); also elsewhere on the board
INPUT2: U3.16 (PC1); also elsewhere on the board
INPUT3: U3.40 (PE9); also elsewhere on the board
KEY_1: U3.55 (PD8); also elsewhere on the board
KEY_2: U3.56 (PD9); also elsewhere on the board
KEY_3: U3.57 (PD10); also elsewhere on the board
KEY_4: U3.58 (PD11); also elsewhere on the board
LCD_DB4: U3.97 (PE0); also elsewhere on the board
LCD_DB5: U3.98 (PE1); also elsewhere on the board
LCD_DB6: U3.1 (PE2); also elsewhere on the board
LCD_DB7: U3.2 (PE3); also elsewhere on the board
LCD_E: U3.3 (PE4); also elsewhere on the board
LCD_PWM: U3.96 (PB9); also elsewhere on the board
LCD_RS: U3.7 (PC13); also elsewhere on the board
LED1_CONTROL: U3.4 (PE5); also elsewhere on the board
LED2_CONTROL: U3.5 (PE6); also elsewhere on the board
LED3: U3.53 (PB14); also elsewhere on the board
LED4: U3.54 (PB15); also elsewhere on the board
LIMIT_Y_BACK: U3.95 (PB8); also elsewhere on the board
LIMIT_Y_FRONT: U3.83 (PD2); also elsewhere on the board
LIMIT_Z_DOWN: U3.82 (PD1); also elsewhere on the board
LIMIT_Z_UP: U3.78 (PC10); also elsewhere on the board
NRST: C94.1, J4.3, R11.2, TP2.1, U3.14 (NRST)
unnamed: C29.1, U3.12 (PH0), Y1.1
unnamed: C30.1, U3.13 (PH1), Y1.2
unnamed: C31.1, C93.1, R10.2, U3.21 (VREF+)
unnamed: C32.1, U3.48 (VCAP1)
unnamed: C33.1, U3.73 (VCAP2)
unnamed: D13.2 (A), R17.2
unnamed: J4.1, R14.1
unnamed: R12.1, U3.94 (BOOT0)
unnamed: R13.1, U3.49 (VSS)
OPC1_SIGNAL: U3.34 (PC5); also elsewhere on the board
OPE_SIGNAL: U3.37 (PB2); also elsewhere on the board
OUTPUT1: U3.52 (PB13); also elsewhere on the board
OUTPUT2: U3.60 (PD13); also elsewhere on the board
PHOTO_SENSOR: U3.38 (PE7); also elsewhere on the board
PRINTER_POWER_DETECT: U3.33 (PC4); also elsewhere on the board
RELAY: U3.41 (PE10); also elsewhere on the board
SPI_MISO: U3.31 (PA6); also elsewhere on the board
SPI_MOSI: U3.32 (PA7); also elsewhere on the board
SPI_SCLK: U3.30 (PA5); also elsewhere on the board
SWCLK: J4.4, TP3.1, U3.76 (PA14)
SWDIO: J4.2, TP1.1, U3.72 (PA13)
TABLE_SENSOR: U3.39 (PE8); also elsewhere on the board
UART_OUT_RX: J5.3, U3.64 (PC7)
UART_OUT_TX: J5.1, U3.63 (PC6)
UART_RX: U3.87 (PD6); also elsewhere on the board
UART_TX: U3.86 (PD5); also elsewhere on the board
USB_D+: U3.71 (PA12), U4.1 (D1)
USB_D-: U3.70 (PA11), U4.3 (D2)
VDDA: C35.1, C36.1, FB9.1, R10.1, U3.22 (VDDA)
Y_DIAG: U3.85 (PD4); also elsewhere on the board
Y_DIR: U3.93 (PB7); also elsewhere on the board
Y_ENABLE: U3.88 (PD7); also elsewhere on the board
Y_INDEX: U3.84 (PD3); also elsewhere on the board
Y_STEP: U3.92 (PB6); also elsewhere on the board
Z_DIAG: U3.80 (PC12); also elsewhere on the board
Z_DIR: U3.91 (PB5); also elsewhere on the board
Z_ENABLE: U3.81 (PD0); also elsewhere on the board
Z_INDEX: U3.79 (PC11); also elsewhere on the board
Z_STEP: U3.90 (PB4); also elsewhere on the board

Notes on the sheet:
for F405 version solder 2.2uF
for F401 solder resistor 0Ω
Przy każdym pinie VDD kondensator 100nF
sprawdzić VBAT
ENC2_B and SWO share pin, be careful
to clear warnings in DRC

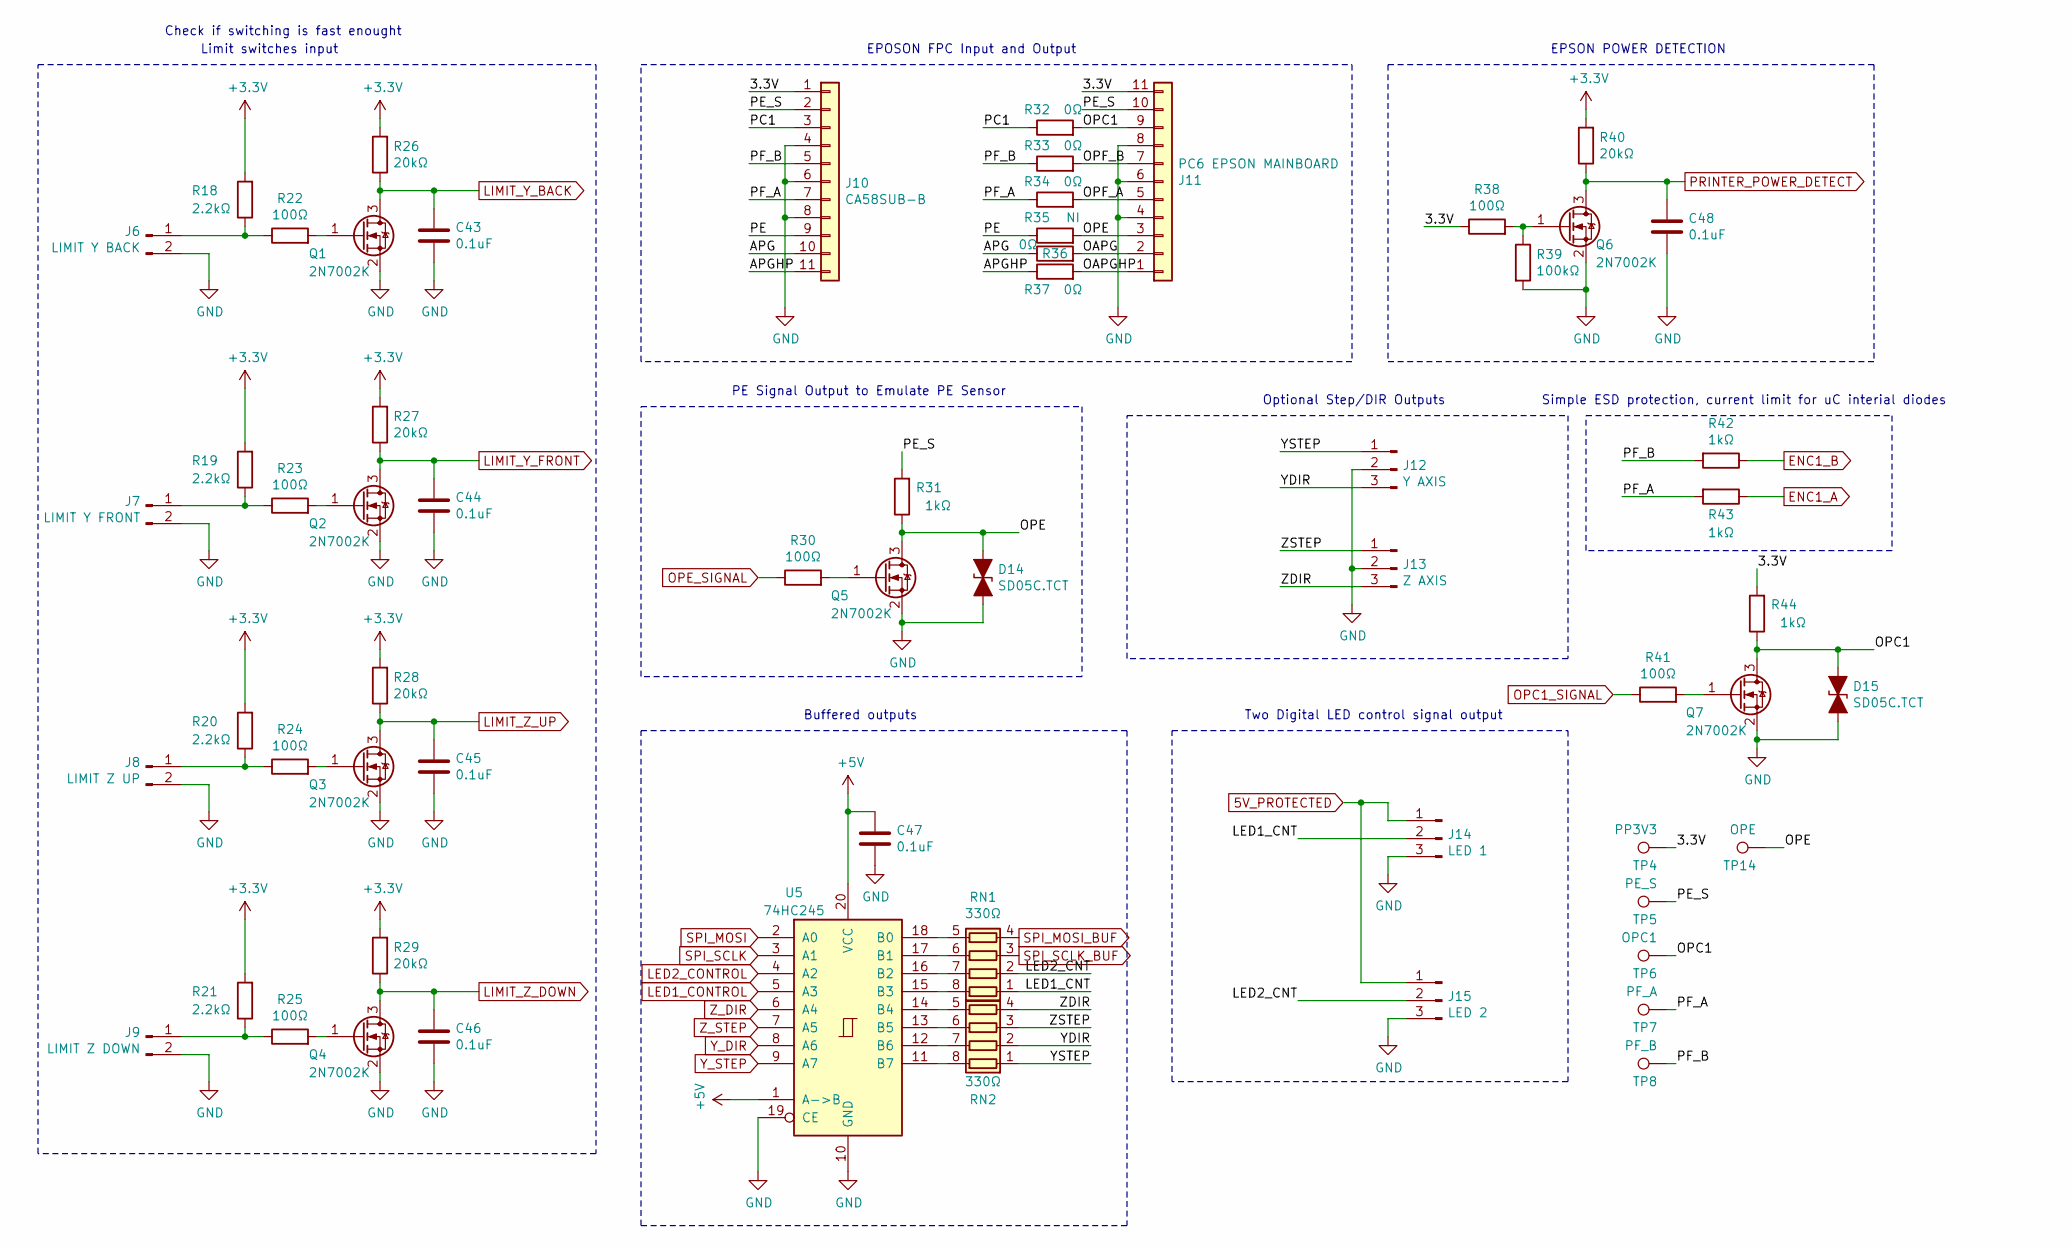
[picture p5: schematic Sockets.sch]

Parts:
C43, C44, C45, C46, C48: 0.1uF; C_0603_1608Metric
C47: 0.1uF; C_0603_1608Metric; Tolerancja 10%
D14, D15: SD05C.TCT; D_SOD-323
J6: LIMIT Y BACK; JST_PH_B2B-PH-K_1x02_P2.00mm_Vertical
J7: LIMIT Y FRONT; JST_PH_B2B-PH-K_1x02_P2.00mm_Vertical
J8: LIMIT Z UP; JST_PH_B2B-PH-K_1x02_P2.00mm_Vertical
J9: LIMIT Z DOWN; JST_PH_B2B-PH-K_1x02_P2.00mm_Vertical
J10: CA58SUB-B; THT_FPC_r1.0mm_11pin_vertical
J11: PC6 EPSON MAINBOARD; THT_FPC_r1.0mm_11pin_vertical
J12: Y AXIS; JST_PH_B3B-PH-K_1x03_P2.00mm_Vertical
J13: Z AXIS; JST_PH_B3B-PH-K_1x03_P2.00mm_Vertical
J14: LED 1; JST_PH_B3B-PH-K_1x03_P2.00mm_Vertical
J15: LED 2; JST_PH_B3B-PH-K_1x03_P2.00mm_Vertical
Q1, Q2, Q3, Q4, Q5, Q6, Q7: 2N7002K; SOT-23
R18, R19, R20, R21: 2.2kΩ; R_0603_1608Metric
R22, R23, R24, R25, R30, R38, R41: 100Ω; R_0603_1608Metric
R26, R27, R28, R29, R40: 20kΩ; R_0603_1608Metric
R31, R42, R43, R44: 1kΩ; R_0603_1608Metric
R32, R33, R34, R36, R37: 0Ω; R_0603_1608Metric
R35: NI; R_0603_1608Metric
R39: 100kΩ; R_0603_1608Metric
RN1, RN2: 330Ω; R_Array_Convex_4x0603
TP4: PP3V3; TestPoint_Pad_D1.5mm
TP5: PE_S; TestPoint_Pad_D1.5mm
TP6: OPC1; TestPoint_Pad_D1.5mm
TP7: PF_A; TestPoint_Pad_D1.5mm
TP8: PF_B; TestPoint_Pad_D1.5mm
TP14: OPE; TestPoint_Pad_D1.5mm
U5: 74HC245; TSSOP-20_4.4x6.5mm_P0.65mm

Connections:
5V_PROTECTED: J14.1, J15.1; also elsewhere on the board
+3V3: R18.2, R19.2, R20.2, R21.2, R26.2, R27.2, R28.2, R29.2, R40.2; also elsewhere on the board
+5V: C47.1, U5.1 (A->B), U5.20 (VCC); also elsewhere on the board
/Sockets/3.3V: J10.1, J11.11, R38.1, R44.2, TP4.1
/Sockets/APG: J10.10, R36.1
/Sockets/APGHP: J10.11, R37.1
/Sockets/LED1_CNT: J14.2, RN1.1 (R1.1)
/Sockets/LED2_CNT: J15.2, RN1.2 (R2.1)
/Sockets/OAPG: J11.2, R36.2
/Sockets/OAPGHP: J11.1, R37.2
/Sockets/OPC1: D15.1 (A1), J11.9, Q7.3 (D), R32.2, R44.1, TP6.1
/Sockets/OPE: D14.1 (A1), J11.3, Q5.3 (D), R31.1, R35.2, TP14.1
/Sockets/OPF_A: J11.5, R34.2
/Sockets/OPF_B: J11.7, R33.2
/Sockets/PC1: J10.3, R32.1
/Sockets/PE: J10.9, R35.1
/Sockets/PE_S: J10.2, J11.10, R31.2, TP5.1
/Sockets/PF_A: J10.7, R34.1, R43.2, TP7.1
/Sockets/PF_B: J10.5, R33.1, R42.2, TP8.1
/Sockets/YDIR: J12.3, RN2.2 (R2.1)
/Sockets/YSTEP: J12.1, RN2.1 (R1.1)
/Sockets/ZDIR: J13.3, RN2.4 (R4.1)
/Sockets/ZSTEP: J13.1, RN2.3 (R3.1)
ENC1_A: R43.1; also elsewhere on the board
ENC1_B: R42.1; also elsewhere on the board
GND: C43.2, C44.2, C45.2, C46.2, C47.2, C48.2, D14.2 (A2), D15.2 (A2), J6.2, J7.2, J8.2, J9.2, J10.4, J10.6, J10.8, J11.4, J11.6, J11.8, J12.2, J13.2, J14.3, J15.3, Q1.2 (S), Q2.2 (S), Q3.2 (S), Q4.2 (S), Q5.2 (S), Q6.2 (S), Q7.2 (S), R39.2, U5.10 (GND), U5.19 (CE); also elsewhere on the board
LED1_CONTROL: U5.5 (A3); also elsewhere on the board
LED2_CONTROL: U5.4 (A2); also elsewhere on the board
LIMIT_Y_BACK: C43.1, Q1.3 (D), R26.1; also elsewhere on the board
LIMIT_Y_FRONT: C44.1, Q2.3 (D), R27.1; also elsewhere on the board
LIMIT_Z_DOWN: C46.1, Q4.3 (D), R29.1; also elsewhere on the board
LIMIT_Z_UP: C45.1, Q3.3 (D), R28.1; also elsewhere on the board
unnamed: J6.1, R18.1, R22.1
unnamed: J7.1, R19.1, R23.1
unnamed: J8.1, R20.1, R24.1
unnamed: J9.1, R21.1, R25.1
unnamed: Q1.1 (G), R22.2
unnamed: Q2.1 (G), R23.2
unnamed: Q3.1 (G), R24.2
unnamed: Q4.1 (G), R25.2
unnamed: Q5.1 (G), R30.2
unnamed: Q6.1 (G), R38.2, R39.1
unnamed: Q7.1 (G), R41.2
unnamed: RN1.5 (R4.2), U5.18 (B0)
unnamed: RN1.6 (R3.2), U5.17 (B1)
unnamed: RN1.7 (R2.2), U5.16 (B2)
unnamed: RN1.8 (R1.2), U5.15 (B3)
unnamed: RN2.5 (R4.2), U5.14 (B4)
unnamed: RN2.6 (R3.2), U5.13 (B5)
unnamed: RN2.7 (R2.2), U5.12 (B6)
unnamed: RN2.8 (R1.2), U5.11 (B7)
OPC1_SIGNAL: R41.1; also elsewhere on the board
OPE_SIGNAL: R30.1; also elsewhere on the board
PRINTER_POWER_DETECT: C48.1, Q6.3 (D), R40.1; also elsewhere on the board
SPI_MOSI: U5.2 (A0); also elsewhere on the board
SPI_MOSI_BUF: RN1.4 (R4.1); also elsewhere on the board
SPI_SCLK: U5.3 (A1); also elsewhere on the board
SPI_SCLK_BUF: RN1.3 (R3.1); also elsewhere on the board
Y_DIR: U5.8 (A6); also elsewhere on the board
Y_STEP: U5.9 (A7); also elsewhere on the board
Z_DIR: U5.6 (A4); also elsewhere on the board
Z_STEP: U5.7 (A5); also elsewhere on the board

Notes on the sheet:
Simple ESD protection, current limit for uC interial diodes
Limit switches input
Check if switching is fast enought
Two Digital LED control signal output
EPOSON FPC Input and Output
PE Signal Output to Emulate PE Sensor
Optional Step/DIR Outputs
EPSON POWER DETECTION
Buffered outputs

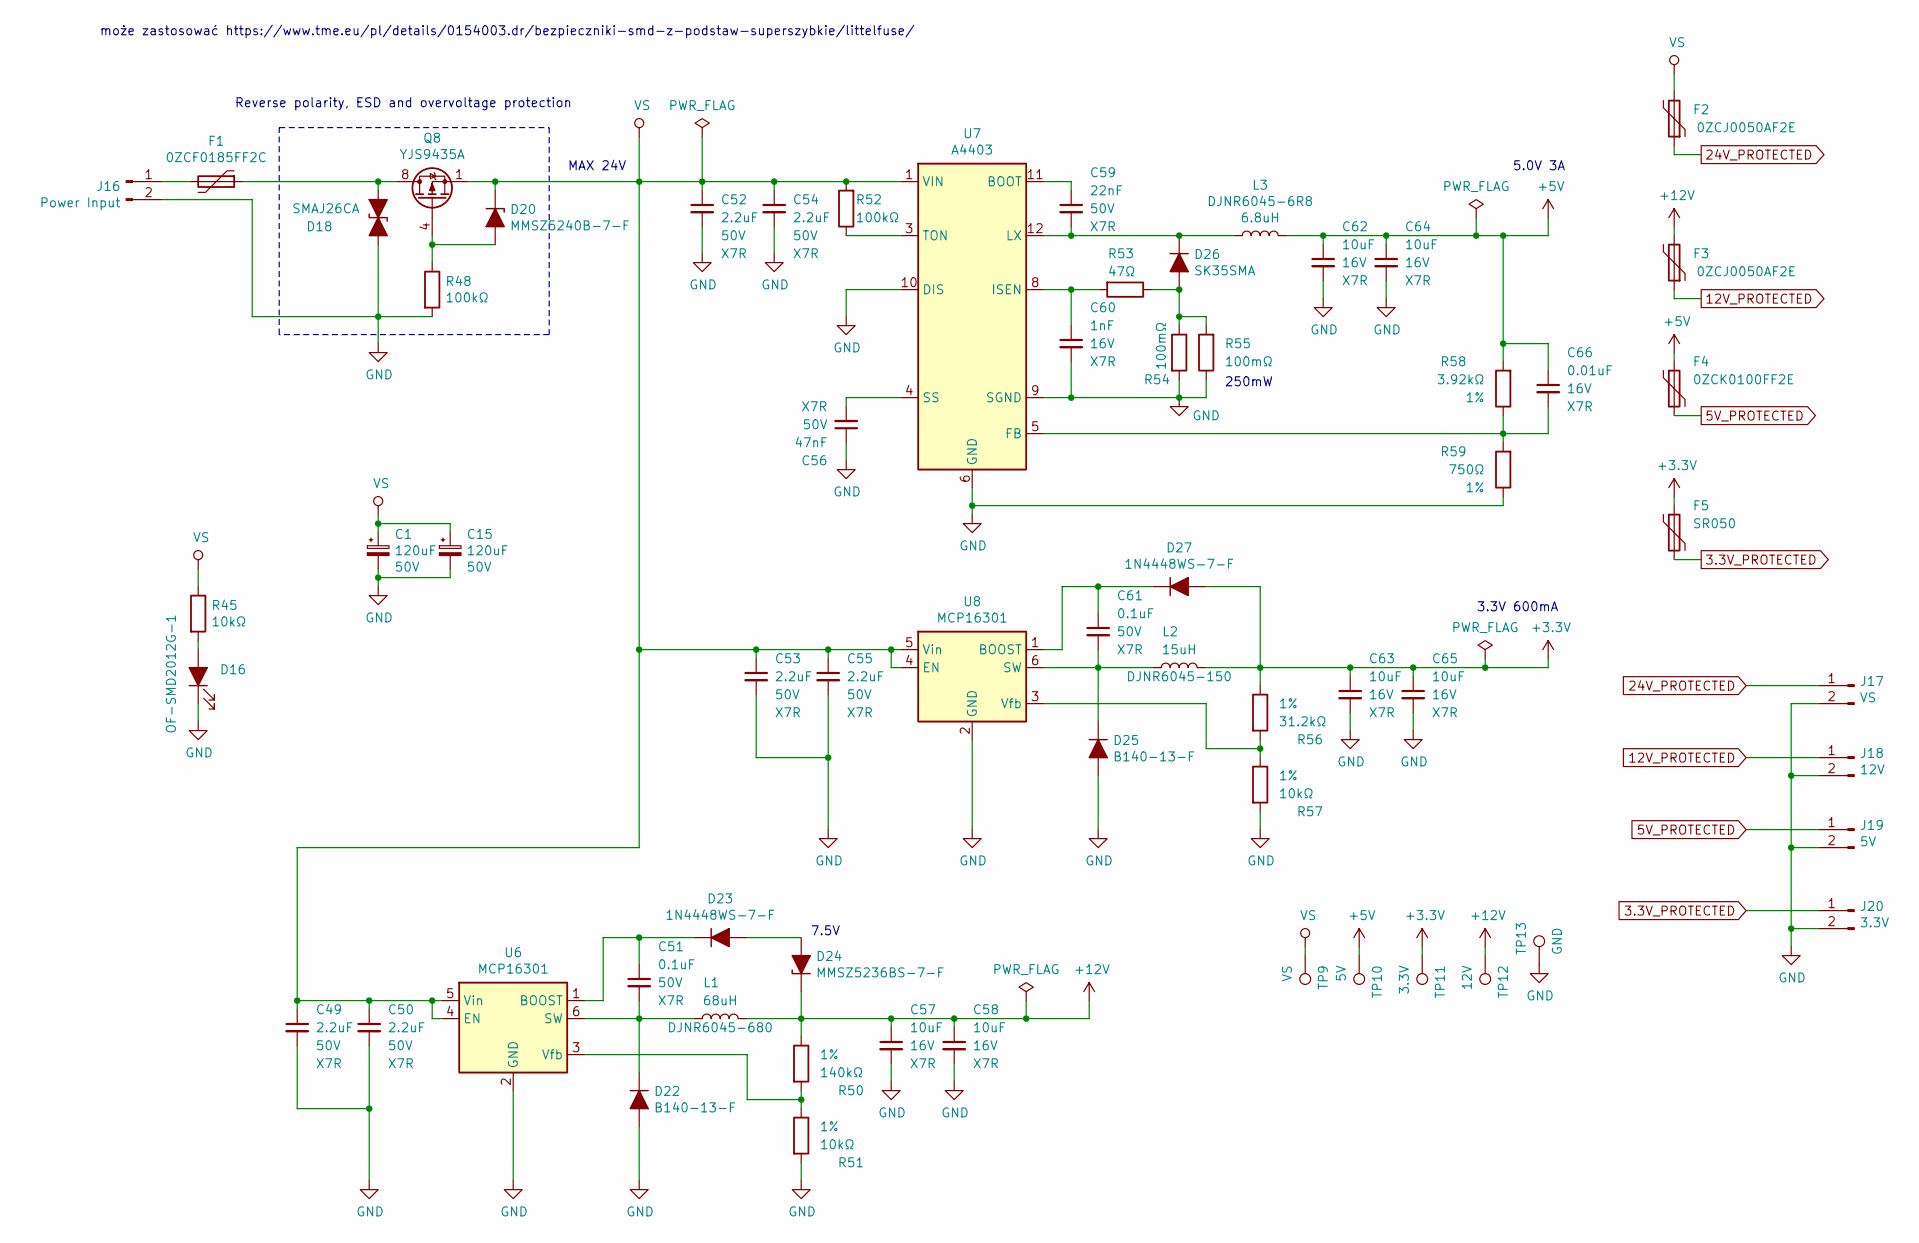
[picture p6: schematic Power.sch]

Parts:
C1, C15: 120uF; CP_Radial_D8.0mm_P3.50mm; Tolerancja 20%
C49, C50, C52, C53, C54, C55: 2.2uF; C_1206_3216Metric
C51, C61: 0.1uF; C_0603_1608Metric; Tolerancja 10%
C56: 47nF; C_0603_1608Metric
C57, C58, C62, C63, C64, C65: 10uF; C_1206_3216Metric; Tolerancja 10%
C59: 22nF; C_0603_1608Metric; Tolerancja 10%
C60: 1nF; C_0603_1608Metric
C66: 0.01uF; C_0603_1608Metric
D16: OF-SMD2012G-1; D_0805_2012Metric
D18: SMAJ26CA; D_SMA
D20: MMSZ5240B-7-F; D_SOD-123
D22, D25: B140-13-F; D_SMA
D23, D27: 1N4448WS-7-F; D_SOD-323
D24: MMSZ5236BS-7-F; D_SOD-323
D26: SK35SMA; D_SMA
F1: 0ZCF0185FF2C; Fuse_2920_7451Metric
F2, F3: 0ZCJ0050AF2E; Fuse_1206_3216Metric
F4: 0ZCK0100FF2E; Fuse_0805_2012Metric
F5: SR050; Fuse_0805_2012Metric
J16: Power Input; JST_XH_B2B-XH-AM_1x02_P2.50mm_Vertical
J17: VS; JST_PH_B2B-PH-K_1x02_P2.00mm_Vertical
J18: 12V; JST_PH_B2B-PH-K_1x02_P2.00mm_Vertical
J19: 5V; JST_PH_B2B-PH-K_1x02_P2.00mm_Vertical
J20: 3.3V; JST_PH_B2B-PH-K_1x02_P2.00mm_Vertical
L1: DJNR6045-680; L_6.2x6.2_H4.5
L2: DJNR6045-150; L_6.2x6.2_H4.5
L3: DJNR6045-6R8; L_6.2x6.2_H4.5
Q8: YJS9435A; SOP-8_3.9x4.9mm_P1.27mm
R45: 10kΩ; R_0805_2012Metric
R48, R52: 100kΩ; R_0603_1608Metric
R50: 140kΩ; R_0603_1608Metric; Tolerancja 1%
R51, R57: 10kΩ; R_0603_1608Metric; Tolerancja 1%
R53: 47Ω; R_0603_1608Metric
R54, R55: 100mΩ; R_1206_3216Metric
R56: 31.2kΩ; R_0603_1608Metric; Tolerancja 1%
R58: 3.92kΩ; R_0603_1608Metric; Tolerancja 1%
R59: 750Ω; R_0603_1608Metric; Tolerancja 1%
TP9: VS; TestPoint_Pad_D1.5mm
TP10: 5V; TestPoint_Pad_D1.5mm
TP11: 3.3V; TestPoint_Pad_D1.5mm
TP12: 12V; TestPoint_Pad_D1.5mm
TP13: GND; TestPoint_Pad_D1.5mm
U6, U8: MCP16301; SOT-23-6
U7: A4403; QFN-16-1EP_4x4mm_P0.65mm_EP2.7x2.7mm

Connections:
3.3V_PROTECTED: F5.2, J20.1; also elsewhere on the board
5V_PROTECTED: F4.2, J19.1; also elsewhere on the board
12V_PROTECTED: F3.1, J18.1; also elsewhere on the board
24V_PROTECTED: F2.1, J17.1; also elsewhere on the board
+3V3: C63.1, C65.1, D27.2 (A), F5.1, L2.2, R56.1, TP11.1; also elsewhere on the board
+5V: C62.1, C64.1, C66.1, F4.1, L3.2, R58.2, TP10.1; also elsewhere on the board
+12V: C57.1, C58.1, D24.1 (K), F3.2, L1.2, R50.1, TP12.1; also elsewhere on the board
GND: C1.2, C15.2, C49.2, C50.2, C52.2, C53.2, C54.2, C55.2, C56.1, C57.2, C58.2, C60.2, C62.2, C63.2, C64.2, C65.2, D16.1 (K), D18.1 (A1), D22.2 (A), D25.2 (A), J16.2, J17.2, J18.2, J19.2, J20.2, R48.2, R51.2, R54.2, R55.1, R57.2, R59.1, TP13.1, U6.2 (GND), U7.2 (GND), U7.6 (GND), U7.7 (GND), U7.9 (SGND), U7.10 (DIS), U7.13 (GND), U7.14 (GND), U7.15 (GND), U7.16 (GND), U7.17 (GND), U8.2 (GND); also elsewhere on the board
unnamed: C51.1, D23.1 (K), U6.1 (BOOST)
unnamed: C51.2, D22.1 (K), L1.1, U6.6 (SW)
unnamed: C56.2, U7.4 (SS)
unnamed: C59.1, U7.11 (BOOT)
unnamed: C59.2, D26.1 (K), L3.1, U7.12 (LX)
unnamed: C60.1, R53.2, U7.8 (ISEN)
unnamed: C61.1, D27.1 (K), U8.1 (BOOST)
unnamed: C61.2, D25.1 (K), L2.1, U8.6 (SW)
unnamed: C66.2, R58.1, R59.2, U7.5 (FB)
unnamed: D16.2 (A), R45.2
unnamed: D18.2 (A2), F1.1, Q8.5 (D), Q8.6 (D), Q8.7 (D), Q8.8 (D)
unnamed: D20.2 (A), Q8.4 (G), R48.1
unnamed: D23.2 (A), D24.2 (A)
unnamed: D26.2 (A), R53.1, R54.1, R55.2
unnamed: F1.2, J16.1
unnamed: R50.2, R51.1, U6.3 (Vfb)
unnamed: R52.1, U7.3 (TON)
unnamed: R56.2, R57.1, U8.3 (Vfb)
VS: C1.1, C15.1, C49.1, C50.1, C52.1, C53.1, C54.1, C55.1, D20.1 (K), F2.2, Q8.1 (S), Q8.2 (S), Q8.3 (S), R45.1, R52.2, TP9.1, U6.4 (EN), U6.5 (Vin), U7.1 (VIN), U8.4 (EN), U8.5 (Vin); also elsewhere on the board

Notes on the sheet:
5.0V 3A
250mW
3.3V 600mA
Reverse polarity, ESD and overvoltage protection
może zastosować https://www.tme.eu/pl/details/0154003.dr/bezpieczniki-smd-z-podstaw-superszybkie/littelfuse/
7.5V
MAX 24V
