awojak/P600-Main-Board/Main Board.kicad_pcb

## KiCad design Main Board.kicad_pcb (continued)

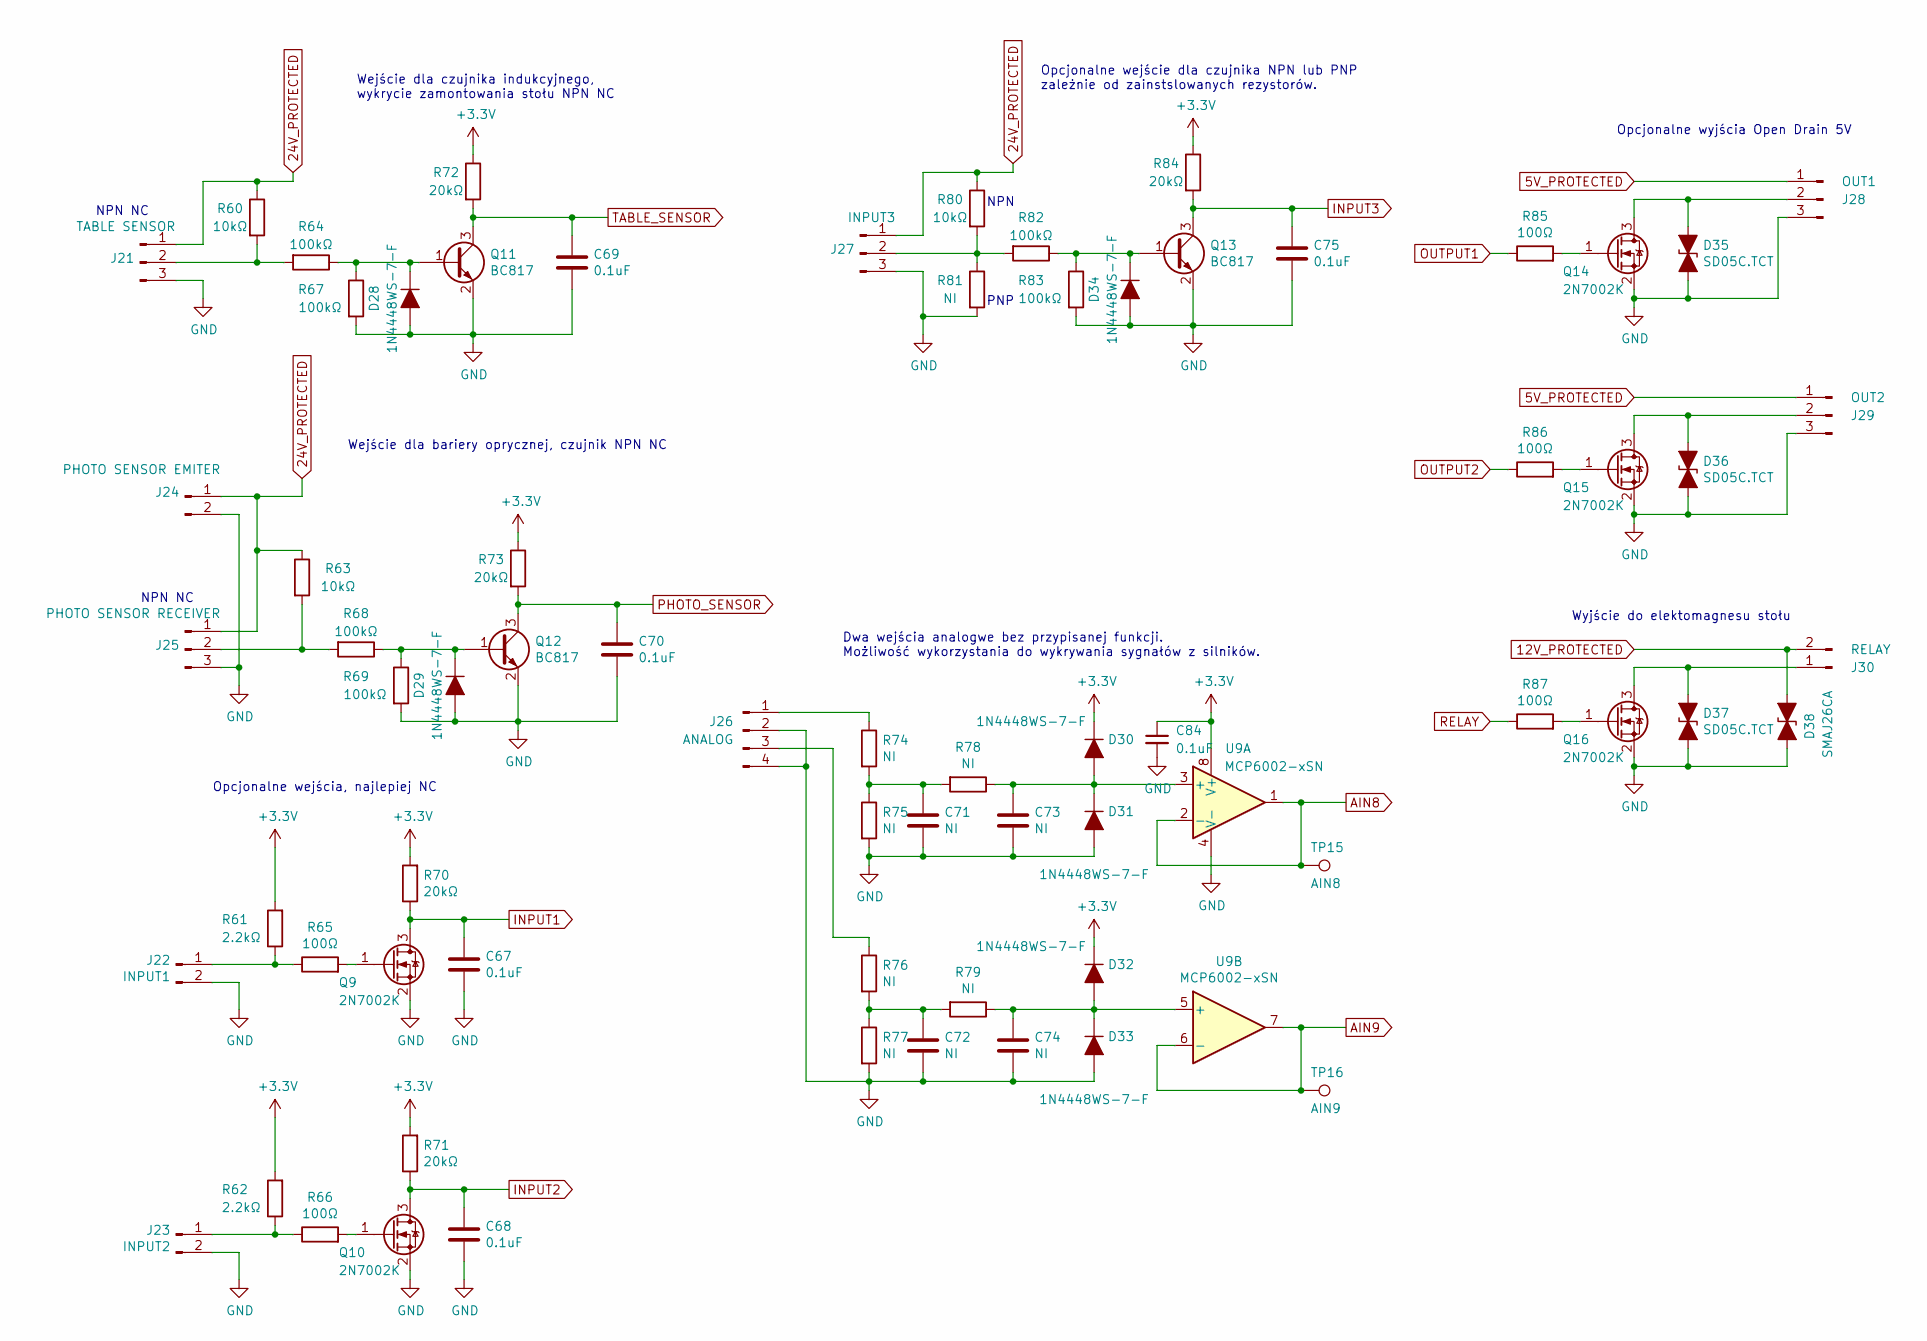
[picture p7: schematic Sockets 2.sch]

Parts:
C67, C68, C69, C70, C75: 0.1uF; C_0603_1608Metric
C71, C72, C73, C74: NI; C_0603_1608Metric
C84: 0.1uF; C_0603_1608Metric; Tolerancja 10%
D28, D29, D30, D31, D32, D33, D34: 1N4448WS-7-F; D_SOD-323
D35, D36, D37: SD05C.TCT; D_SOD-323
D38: SMAJ26CA; D_SMA
J21: TABLE SENSOR; JST_PH_B3B-PH-K_1x03_P2.00mm_Vertical
J22: INPUT1; JST_PH_B2B-PH-K_1x02_P2.00mm_Vertical
J23: INPUT2; JST_PH_B2B-PH-K_1x02_P2.00mm_Vertical
J24: PHOTO SENSOR EMITER; JST_PH_B2B-PH-K_1x02_P2.00mm_Vertical
J25: PHOTO SENSOR RECEIVER; JST_PH_B3B-PH-K_1x03_P2.00mm_Vertical
J26: ANALOG; JST_PH_B4B-PH-K_1x04_P2.00mm_Vertical
J27: INPUT3; JST_PH_B3B-PH-K_1x03_P2.00mm_Vertical
J28: OUT1; JST_PH_B3B-PH-K_1x03_P2.00mm_Vertical
J29: OUT2; JST_PH_B3B-PH-K_1x03_P2.00mm_Vertical
J30: RELAY; JST_PH_B2B-PH-K_1x02_P2.00mm_Vertical
Q9, Q10, Q14, Q15, Q16: 2N7002K; SOT-23
Q11, Q12, Q13: BC817; SOT-23
R60, R63, R80: 10kΩ; R_0603_1608Metric
R61, R62: 2.2kΩ; R_0603_1608Metric
R64, R67, R68, R69, R82, R83: 100kΩ; R_0603_1608Metric
R65, R66, R85, R86, R87: 100Ω; R_0603_1608Metric
R70, R71, R72, R73, R84: 20kΩ; R_0603_1608Metric
R74, R75, R76, R77, R78, R79, R81: NI; R_0603_1608Metric
TP15: AIN8; TestPoint_Pad_D1.5mm
TP16: AIN9; TestPoint_Pad_D1.5mm
U9: MCP6002-xSN; SOIC-8_3.9x4.9mm_P1.27mm

Connections:
5V_PROTECTED: J28.1, J29.1; also elsewhere on the board
12V_PROTECTED: D38.1 (A1), J30.2; also elsewhere on the board
24V_PROTECTED: J21.1, J24.1, J25.1, J27.1, R60.1, R63.1, R80.1; also elsewhere on the board
+3V3: C84.1, D30.1 (K), D32.1 (K), R61.2, R62.2, R70.2, R71.2, R72.1, R73.1, R84.1, U9.8 (V+); also elsewhere on the board
AIN8: TP15.1, U9.1, U9.2 (-); also elsewhere on the board
AIN9: TP16.1, U9.6 (-), U9.7; also elsewhere on the board
GND: C67.2, C68.2, C69.2, C70.2, C71.2, C72.2, C73.2, C74.2, C75.2, C84.2, D28.2 (A), D29.2 (A), D31.2 (A), D33.2 (A), D34.2 (A), D35.2 (A2), D36.2 (A2), D37.2 (A2), D38.2 (A2), J21.3, J22.2, J23.2, J24.2, J25.3, J26.2, J26.4, J27.3, J28.3, J29.3, Q9.2 (S), Q10.2 (S), Q11.2 (E), Q12.2 (E), Q13.2 (E), Q14.2 (S), Q15.2 (S), Q16.2 (S), R67.2, R69.2, R75.2, R77.2, R81.2, R83.2, U9.4 (V-); also elsewhere on the board
INPUT1: C67.1, Q9.3 (D), R70.1; also elsewhere on the board
INPUT2: C68.1, Q10.3 (D), R71.1; also elsewhere on the board
INPUT3: C75.1, Q13.3 (C), R84.2; also elsewhere on the board
unnamed: C71.1, R74.2, R75.1, R78.2
unnamed: C72.1, R76.2, R77.1, R79.2
unnamed: C73.1, D30.2 (A), D31.1 (K), R78.1, U9.3 (+)
unnamed: C74.1, D32.2 (A), D33.1 (K), R79.1, U9.5 (+)
unnamed: D28.1 (K), Q11.1 (B), R64.1, R67.1
unnamed: D29.1 (K), Q12.1 (B), R68.1, R69.1
unnamed: D34.1 (K), Q13.1 (B), R82.1, R83.1
unnamed: D35.1 (A1), J28.2, Q14.3 (D)
unnamed: D36.1 (A1), J29.2, Q15.3 (D)
unnamed: D37.1 (A1), J30.1, Q16.3 (D)
unnamed: J21.2, R60.2, R64.2
unnamed: J22.1, R61.1, R65.1
unnamed: J23.1, R62.1, R66.1
unnamed: J25.2, R63.2, R68.2
unnamed: J26.1, R74.1
unnamed: J26.3, R76.1
unnamed: J27.2, R80.2, R81.1, R82.2
unnamed: Q9.1 (G), R65.2
unnamed: Q10.1 (G), R66.2
unnamed: Q14.1 (G), R85.2
unnamed: Q15.1 (G), R86.2
unnamed: Q16.1 (G), R87.2
OUTPUT1: R85.1; also elsewhere on the board
OUTPUT2: R86.1; also elsewhere on the board
PHOTO_SENSOR: C70.1, Q12.3 (C), R73.2; also elsewhere on the board
RELAY: R87.1; also elsewhere on the board
TABLE_SENSOR: C69.1, Q11.3 (C), R72.2; also elsewhere on the board

Notes on the sheet:
NPN NC
NPN
PNP
Dwa wejścia analogwe bez przypisanej funkcji. Możliwość wykorzystania do wykrywania sygnałów z silników.
Wejście dla bariery oprycznej, czujnik NPN NC
Wejście dla czujnika indukcyjnego, wykrycie zamontowania stołu NPN NC
Opcjonalne wejście dla czujnika NPN lub PNP zależnie od zainstslowanych rezystorów.
Opcjonalne wyjścia Open Drain 5V
Wyjście do elektomagnesu stołu
Opcjonalne wejścia, najlepiej NC

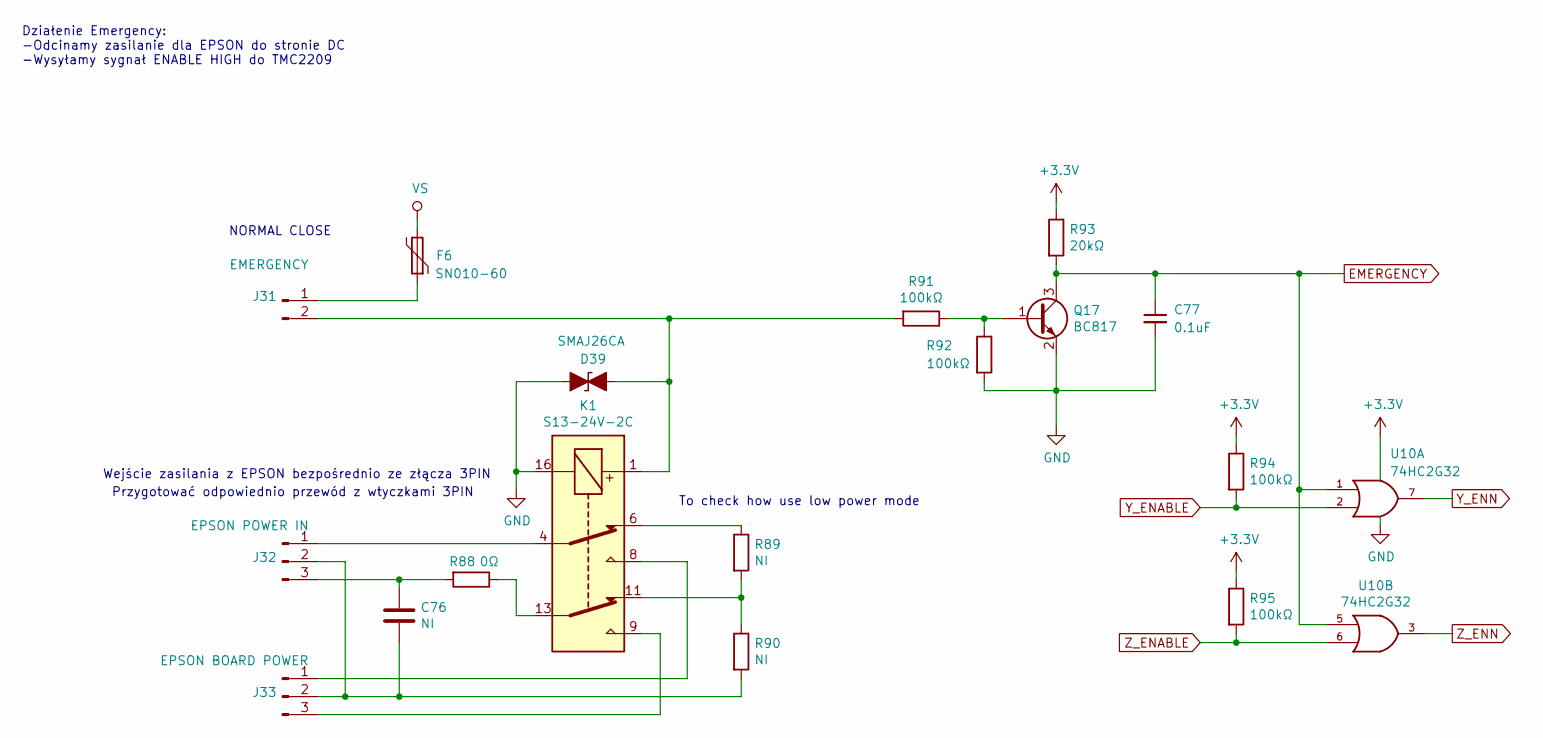
[picture p8: schematic Emergency.sch]

Parts:
C76: NI; C_0805_2012Metric
C77: 0.1uF; C_0603_1608Metric
D39: SMAJ26CA; D_SMA
F6: SN010-60; Fuse_1206_3216Metric
J31: EMERGENCY; JST_PH_B2B-PH-K_1x02_P2.00mm_Vertical
J32: EPSON POWER IN; JST_PH_B3B-PH-K_1x03_P2.00mm_Vertical
J33: EPSON BOARD POWER; JST_PH_B3B-PH-K_1x03_P2.00mm_Vertical
K1: S13-24V-2C; Relay_DPDT_Omron_G5V-2
Q17: BC817; SOT-23
R88: 0Ω; R_0805_2012Metric
R89, R90: NI; R_0805_2012Metric
R91, R92, R94, R95: 100kΩ; R_0603_1608Metric
R93: 20kΩ; R_0603_1608Metric
U10: 74HC2G32; VSSOP-8_2.3x2mm_P0.5mm

Connections:
+3V3: R93.1, R94.1, R95.1, U10.8 (VCC); also elsewhere on the board
EMERGENCY: C77.1, Q17.3 (C), R93.2, U10.1, U10.5; also elsewhere on the board
GND: C77.2, D39.1 (A1), K1.16, Q17.2 (E), R92.2, U10.4 (GND); also elsewhere on the board
unnamed: C76.1, J32.3, R88.2
unnamed: C76.2, J32.2, J33.2, R90.2
unnamed: D39.2 (A2), J31.2, K1.1, R91.2
unnamed: F6.1, J31.1
unnamed: J32.1, K1.4
unnamed: J33.1, K1.8
unnamed: J33.3, K1.9
unnamed: K1.6, R89.1
unnamed: K1.11, R89.2, R90.1
unnamed: K1.13, R88.1
unnamed: Q17.1 (B), R91.1, R92.1
VS: F6.2; also elsewhere on the board
Y_ENABLE: R94.2, U10.2; also elsewhere on the board
Y_ENN: U10.7; also elsewhere on the board
Z_ENABLE: R95.2, U10.6; also elsewhere on the board
Z_ENN: U10.3; also elsewhere on the board

Notes on the sheet:
Działenie Emergency: -Odcinamy zasilanie dla EPSON do stronie DC -Wysyłamy sygnał ENABLE HIGH do TMC2209
Wejście zasilania z EPSON bezpośrednio ze złącza 3PIN
Przygotować odpowiednio przewód z wtyczkami 3PIN
NORMAL CLOSE
To check how use low power mode

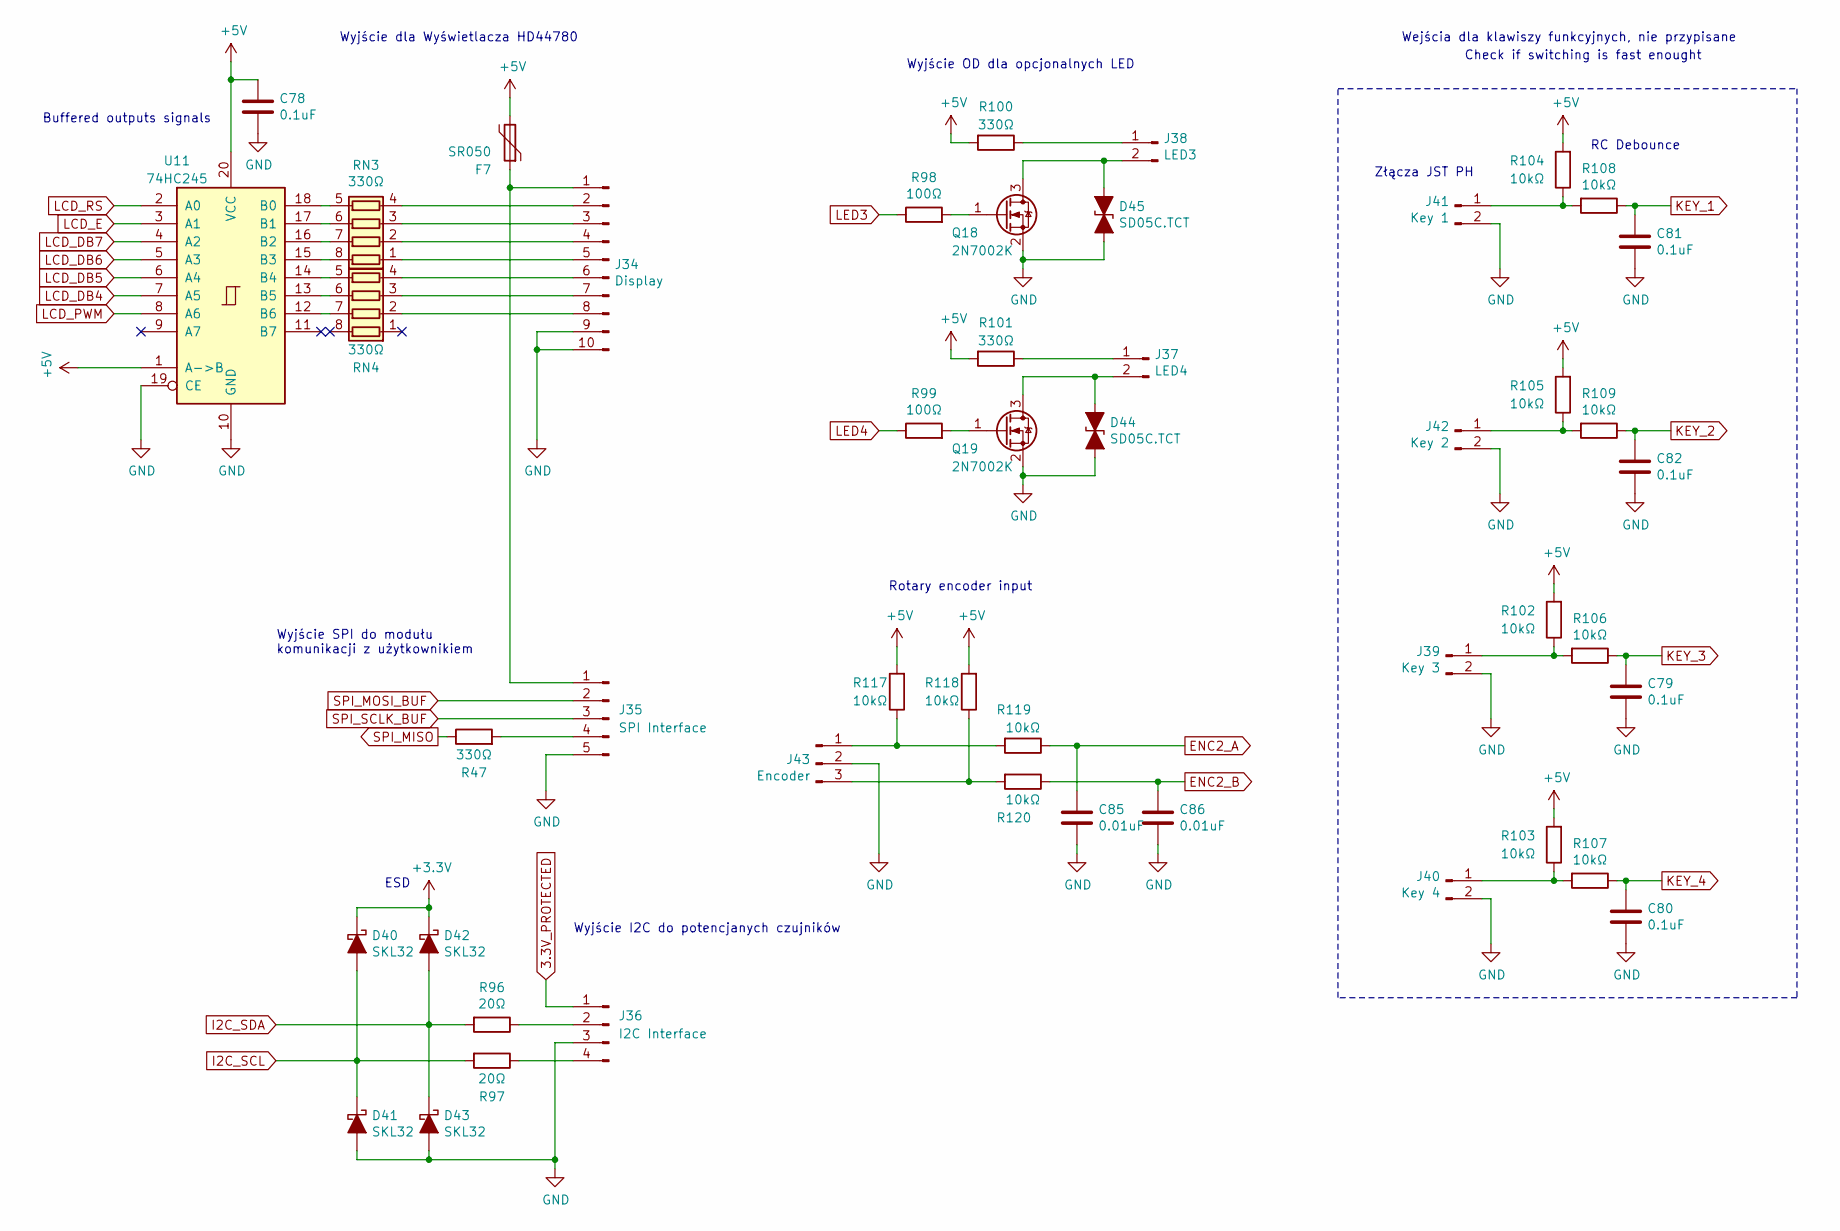
[picture p9: schematic HMI.sch]

Parts:
C78: 0.1uF; C_0603_1608Metric; Tolerancja 10%
C79, C80, C81, C82: 0.1uF; C_0603_1608Metric
C85, C86: 0.01uF; C_0603_1608Metric
D40, D41, D42, D43: SKL32; D_SOD-123F
D44, D45: SD05C.TCT; D_SOD-323
F7: SR050; Fuse_0805_2012Metric
J34: Display; JST_PH_B10B-PH-K_1x10_P2.00mm_Vertical
J35: SPI Interface; JST_PH_B5B-PH-K_1x05_P2.00mm_Vertical
J36: I2C Interface; JST_PH_B4B-PH-K_1x04_P2.00mm_Vertical
J37: LED4; JST_PH_B2B-PH-K_1x02_P2.00mm_Vertical
J38: LED3; JST_PH_B2B-PH-K_1x02_P2.00mm_Vertical
J39: Key 3; JST_PH_B2B-PH-K_1x02_P2.00mm_Vertical
J40: Key 4; JST_PH_B2B-PH-K_1x02_P2.00mm_Vertical
J41: Key 1; JST_PH_B2B-PH-K_1x02_P2.00mm_Vertical
J42: Key 2; JST_PH_B2B-PH-K_1x02_P2.00mm_Vertical
J43: Encoder; JST_PH_B3B-PH-K_1x03_P2.00mm_Vertical
Q18, Q19: 2N7002K; SOT-23
R47, R100, R101: 330Ω; R_0603_1608Metric
R96, R97: 20Ω; R_0603_1608Metric
R98, R99: 100Ω; R_0603_1608Metric
R102, R103, R104, R105, R106, R107, R108, R109, R117, R118, R119, R120: 10kΩ; R_0603_1608Metric
RN3, RN4: 330Ω; R_Array_Convex_4x0603
U11: 74HC245; TSSOP-20_4.4x6.5mm_P0.65mm

Connections:
3.3V_PROTECTED: J36.1; also elsewhere on the board
+3V3: D40.1 (K), D42.1 (K); also elsewhere on the board
+5V: C78.1, F7.2, R100.2, R101.2, R102.2, R103.2, R104.2, R105.2, R117.2, R118.2, U11.1 (A->B), U11.20 (VCC); also elsewhere on the board
ENC2_A: C85.1, R119.1; also elsewhere on the board
ENC2_B: C86.1, R120.1; also elsewhere on the board
GND: C78.2, C79.2, C80.2, C81.2, C82.2, C85.2, C86.2, D41.2 (A), D43.2 (A), D44.2 (A2), D45.2 (A2), J34.9, J34.10, J35.5, J36.3, J39.2, J40.2, J41.2, J42.2, J43.2, Q18.2 (S), Q19.2 (S), U11.10 (GND), U11.19 (CE); also elsewhere on the board
I2C_SCL: D40.2 (A), D41.1 (K), R97.2; also elsewhere on the board
I2C_SDA: D42.2 (A), D43.1 (K), R96.2; also elsewhere on the board
KEY_1: C81.1, R108.1; also elsewhere on the board
KEY_2: C82.1, R109.1; also elsewhere on the board
KEY_3: C79.1, R106.1; also elsewhere on the board
KEY_4: C80.1, R107.1; also elsewhere on the board
LCD_DB4: U11.7 (A5); also elsewhere on the board
LCD_DB5: U11.6 (A4); also elsewhere on the board
LCD_DB6: U11.5 (A3); also elsewhere on the board
LCD_DB7: U11.4 (A2); also elsewhere on the board
LCD_E: U11.3 (A1); also elsewhere on the board
LCD_PWM: U11.8 (A6); also elsewhere on the board
LCD_RS: U11.2 (A0); also elsewhere on the board
LED3: R98.1; also elsewhere on the board
LED4: R99.1; also elsewhere on the board
unnamed: D44.1 (A1), J37.2, Q19.3 (D)
unnamed: D45.1 (A1), J38.2, Q18.3 (D)
unnamed: F7.1, J34.1, J35.1
unnamed: J34.2, RN3.4 (R4.1)
unnamed: J34.3, RN3.3 (R3.1)
unnamed: J34.4, RN3.2 (R2.1)
unnamed: J34.5, RN3.1 (R1.1)
unnamed: J34.6, RN4.4 (R4.1)
unnamed: J34.7, RN4.3 (R3.1)
unnamed: J34.8, RN4.2 (R2.1)
unnamed: J35.4, R47.2
unnamed: J36.2, R96.1
unnamed: J36.4, R97.1
unnamed: J37.1, R101.1
unnamed: J38.1, R100.1
unnamed: J39.1, R102.1, R106.2
unnamed: J40.1, R103.1, R107.2
unnamed: J41.1, R104.1, R108.2
unnamed: J42.1, R105.1, R109.2
unnamed: J43.1, R117.1, R119.2
unnamed: J43.3, R118.1, R120.2
unnamed: Q18.1 (G), R98.2
unnamed: Q19.1 (G), R99.2
unnamed: RN3.5 (R4.2), U11.18 (B0)
unnamed: RN3.6 (R3.2), U11.17 (B1)
unnamed: RN3.7 (R2.2), U11.16 (B2)
unnamed: RN3.8 (R1.2), U11.15 (B3)
unnamed: RN4.5 (R4.2), U11.14 (B4)
unnamed: RN4.6 (R3.2), U11.13 (B5)
unnamed: RN4.7 (R2.2), U11.12 (B6)
SPI_MISO: R47.1; also elsewhere on the board
SPI_MOSI_BUF: J35.2; also elsewhere on the board
SPI_SCLK_BUF: J35.3; also elsewhere on the board

Notes on the sheet:
Wyjście dla Wyświetlacza HD44780
Buffered outputs signals
Złącza JST PH
Wejścia dla klawiszy funkcyjnych, nie przypisane
RC Debounce
Check if switching is fast enought
ESD
Wyjście I2C do potencjanych czujników
Wyjście SPI do modułu komunikacji z użytkownikiem
Wyjście OD dla opcjonalnych LED
Rotary encoder input

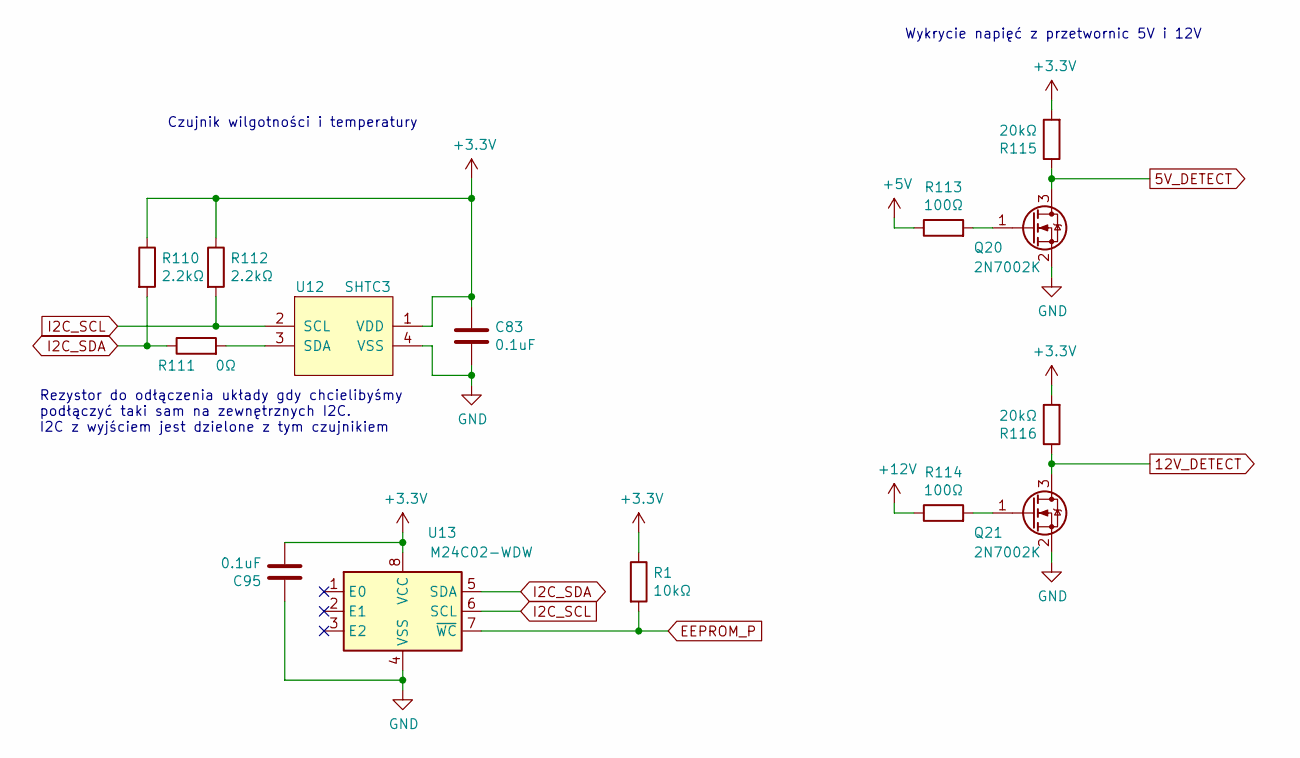
[picture p10: schematic Sensors.sch]

Parts:
C83, C95: 0.1uF; C_0603_1608Metric; Tolerancja 10%
Q20, Q21: 2N7002K; SOT-23
R1: 10kΩ; R_0603_1608Metric
R110, R112: 2.2kΩ; R_0603_1608Metric
R111: 0Ω; R_0603_1608Metric
R113, R114: 100Ω; R_0603_1608Metric
R115, R116: 20kΩ; R_0603_1608Metric
U12: SHTC3; DFN-4-1EP_2x2mm_P1mm_EP0.7x1.6mm
U13: M24C02-WDW; TSSOP-8_4.4x3mm_P0.65mm

Connections:
5V_DETECT: Q20.3 (D), R115.1; also elsewhere on the board
12V_DETECT: Q21.3 (D), R116.1; also elsewhere on the board
+3V3: C83.1, C95.2, R1.1, R110.1, R112.1, R115.2, R116.2, U12.1 (VDD), U13.8 (VCC); also elsewhere on the board
+5V: R113.1; also elsewhere on the board
+12V: R114.1; also elsewhere on the board
EEPROM_P: R1.2, U13.7 (~WC); also elsewhere on the board
GND: C83.2, C95.1, Q20.2 (S), Q21.2 (S), U12.4 (VSS), U13.4 (VSS); also elsewhere on the board
I2C_SCL: R112.2, U12.2 (SCL), U13.6 (SCL); also elsewhere on the board
I2C_SDA: R110.2, R111.1, U13.5 (SDA); also elsewhere on the board
unnamed: Q20.1 (G), R113.2
unnamed: Q21.1 (G), R114.2
unnamed: R111.2, U12.3 (SDA)

Notes on the sheet:
Wykrycie napięć z przetwornic 5V i 12V
Czujnik wilgotności i temperatury
Rezystor do odłączenia układy gdy chcielibyśmy podłączyć taki sam na zewnętrznych I2C. I2C z wyjściem jest dzielone z tym czujnikiem

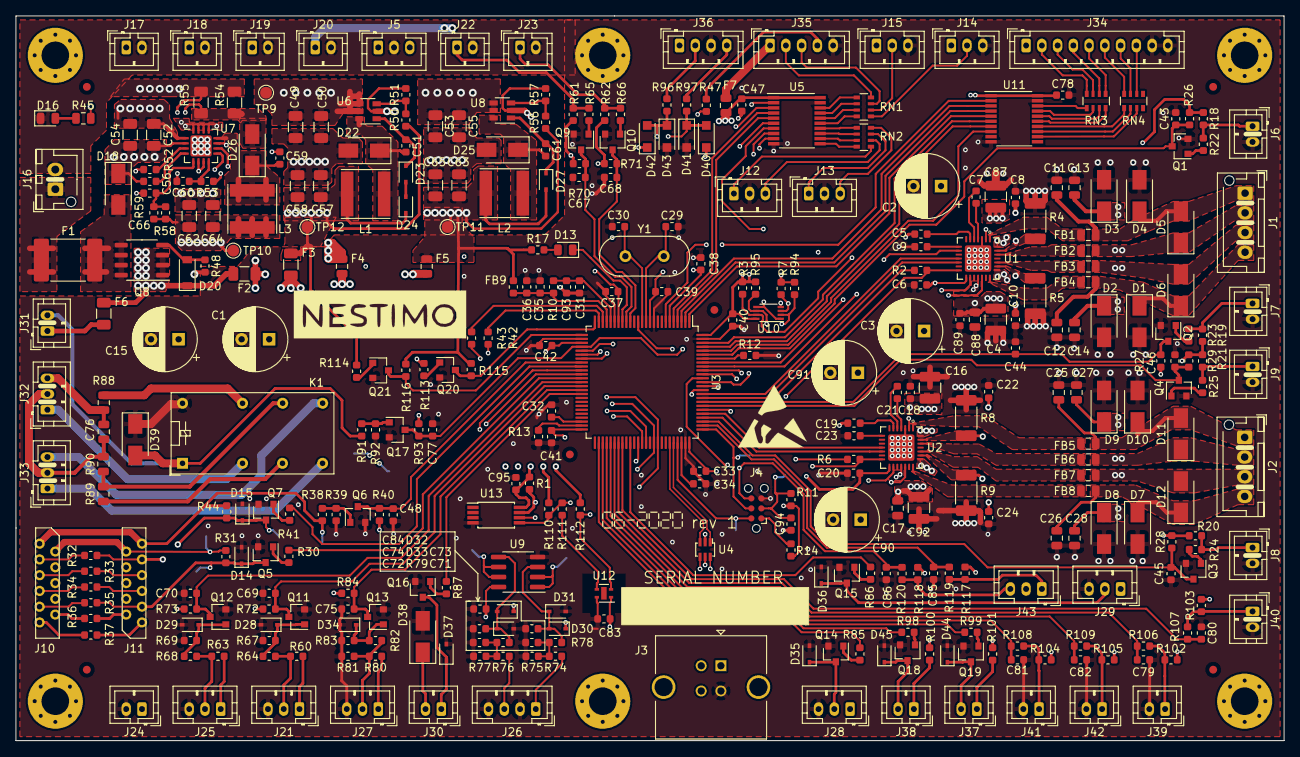
[picture p11: board Main Board.kicad_pcb from above]

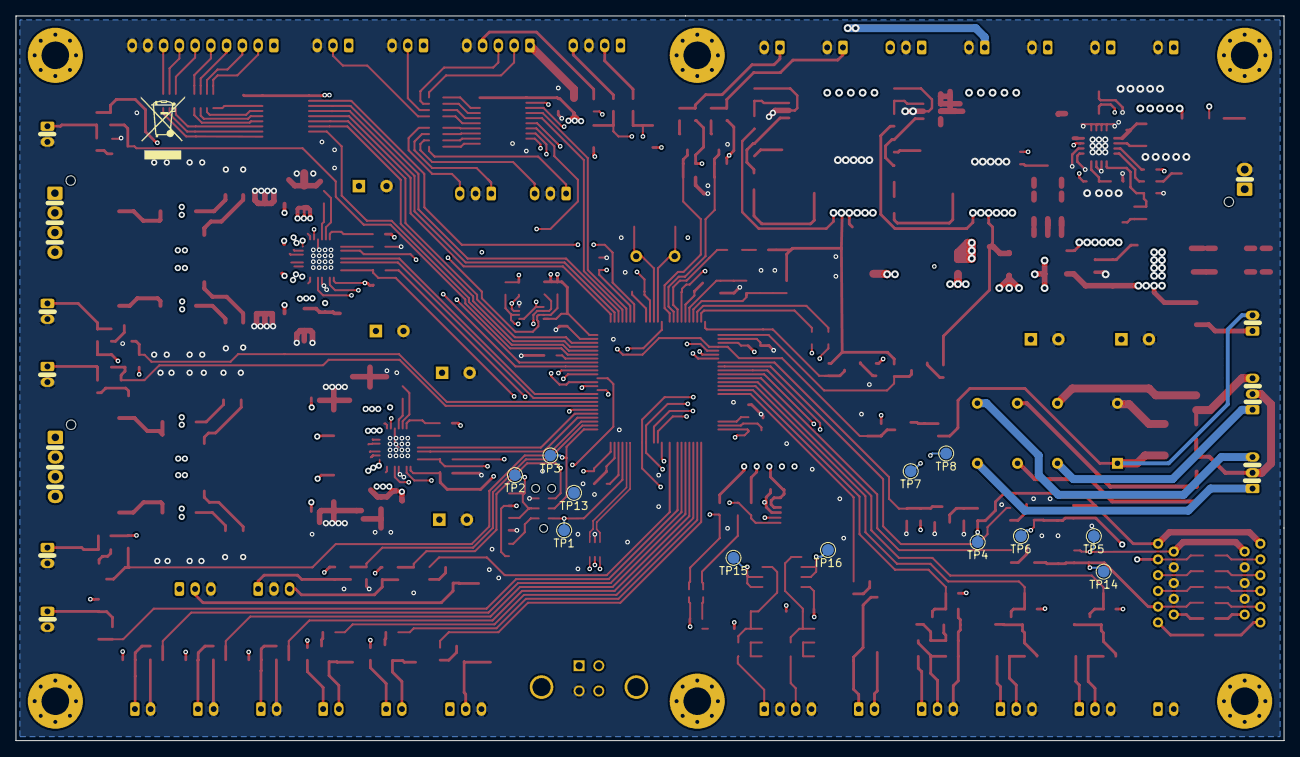
[picture p12: board Main Board.kicad_pcb from below]

Board: 4 copper layers, 161.0 x 92.0 mm, 383 parts (12 on the bottom side), 241 nets.
