awojak/P600-Main-Board/(commit log)

2019-12-04 Init Commit
    [Main Board.kicad_pcb, Main Board.sch, Y Axis Motor Driver.sch, Z Axis Motor Driver.sch]
2019-12-20 Added stm32f401
    [Main Board.sch, Microcontroller.sch, Sockets.sch, Y Axis Motor Driver.sch, Z Axis Motor Driver.sch]
2019-12-22 Finished TMC2209 schematic for Y and Z motor, added BOM
    [BOM.xlsx, Main Board.sch, Microcontroller.sch, Sockets.sch, Y Axis Motor Driver.sch, Z Axis Motor Driver.sch]
2020-01-02 Added Power.sch and update BOM
    [BOM.xlsx, Main Board.sch, Microcontroller.sch, Power.sch, Sockets.sch, Y Axis Motor Driver.sch, Z Axis Motor Driver.sch]
2020-01-02 Finished Power Managment
    [BOM.xlsx, Main Board.sch, Power.sch]
2020-01-03 Added Input Limit Switch
    [Sockets.sch]
2020-01-05 Finished Emergency Circuit
    [BOM.xlsx, Emergency.sch, HMI.sch, Main Board.sch, Microcontroller.sch, Power.sch, Sockets 2.sch, Sockets.sch]
2020-01-06 Added Polyfuses and replace diodes
    [Emergency.sch, HMI.sch, Main Board.sch, Microcontroller.sch, Power.sch, Sensors.sch, Sockets.sch, Y Axis Motor Driver.sch]
2020-01-06 Added USB B socket with ESD filter
    [BOM.xlsx, HMI.sch, Main Board.sch, Microcontroller.sch, Sockets.sch, Y Axis Motor Driver.sch]
2020-01-07 Added SWD and Debug out
    [HMI.sch, Microcontroller.sch]
2020-01-07 Improve schematics add new elements
    [Emergency.sch, HMI.sch, Microcontroller.sch, Power.sch, Sensors.sch, Sockets 2.sch, Sockets.sch]
2020-01-08 Numbering and finishing the schematic
    [Emergency.sch, HMI.sch, Main Board.sch, Microcontroller.sch, Power.sch, Sensors.sch, Sockets 2.sch, Sockets.sch]
2020-01-08 Shematic almost finished, BOM in KiCad 3/4 finished
    [Emergency.sch, HMI.sch, Main Board.sch, Microcontroller.sch, Power.sch, Sensors.sch, Sockets 2.sch, Sockets.sch]
2020-01-09 BOM in KiCad almost finished, genereated NETLIST, create PCB
    [Emergency.sch, HMI.sch, Main Board.kicad_pcb, Microcontroller.sch, Power.sch, Sensors.sch, Sockets 2.sch, Sockets.sch]
2020-01-09 Generated BOM
    [BOM.xlsx, BOMRaw.csv, GrupedBOMRaw.csv, Main Board.sch]
2020-01-09 Improve Emergency, Added TVS diodes
    [Emergency.sch, HMI.sch, Microcontroller.sch, Power.sch, Sensors.sch, Sockets 2.sch, Sockets.sch]
2020-01-10 Update USBUF02W6
    [Microcontroller.sch]
2020-01-10 Added 12V regulator, aditional input, outputs, improved inputs ESD
    [Emergency.sch, HMI.sch, Main Board.kicad_pcb, Microcontroller.sch, Power.sch, Sensors.sch, Sockets 2.sch, Sockets.sch]
2020-01-11 Added analog input
    [Emergency.sch, HMI.sch, Main Board.kicad_pcb, Microcontroller.sch, Power.sch, Sensors.sch, Sockets 2.sch, Sockets.sch]
2020-01-11 Improve ESD Protection for TMC2209, Fuses. Schematic ready v1
    [Emergency.sch, HMI.sch, Microcontroller.sch, Power.sch, Sensors.sch, Sockets 2.sch, Sockets.sch, Y Axis Motor Driver.sch]
2020-01-11 Dodano brakujący footprint dla R1
    [Y Axis Motor Driver.sch]
2020-01-12 Routing of the power supplies are finished
    [Main Board.kicad_pcb, Power.sch]
2020-01-12 Rozmieszczenie elementów, trasowanie ścieżek, etap 2/4
    [Main Board.kicad_pcb, Main Board.sch, Sockets 2.sch]
2020-01-13 Update footprint L_6.2x6.2_H4.5.kicad_mod
2020-01-13 Update Crystal footprint and inductor 3D package on PCB
    [Main Board.kicad_pcb, Microcontroller.sch]
2020-01-13 Added JST FMN, USB Type B, JST XH 3d package. Update PCB
    [Main Board.kicad_pcb]
2020-01-13 Change SWD IDC connector to TC2030
    [Main Board.kicad_pcb, Microcontroller.sch]
2020-01-13 Change USB Horizontal to Vertical
    [Main Board.kicad_pcb, Microcontroller.sch]
2020-01-13 Added git ignore, updated part info for USB socket
    [Microcontroller.sch]
2020-01-13 Start ignoring .kicad_pcb-bak
2020-01-14 Added rotary encoder input
    [HMI.sch, Main Board.kicad_pcb, Microcontroller.sch]
2020-01-14 Modify pin attribute, routing keys input
    [Main Board.kicad_pcb, Microcontroller.sch, Sockets.sch]
2020-01-15 Routing emergnency, photo barier, relay, voltage detect, analog, footprint improvment
    [Main Board.kicad_pcb, Microcontroller.sch, Power.sch, Y Axis Motor Driver.sch, Z Axis Motor Driver.sch]
2020-01-16 Start TMC routing
    [Main Board.kicad_pcb, Y Axis Motor Driver.sch, Z Axis Motor Driver.sch]
2020-01-16 TMC2209 routing step 2/3
    [Emergency.sch, Main Board.kicad_pcb, Power.sch, Y Axis Motor Driver.sch, Z Axis Motor Driver.sch]
2020-01-17 Routing almost finished
    [HMI.sch, Main Board.kicad_pcb, Microcontroller.sch, Sockets.sch]
2020-01-21 Test points, start power plane routing, little change on schematic
    [Emergency.sch, HMI.sch, Main Board.kicad_pcb, Microcontroller.sch, Sockets 2.sch, Sockets.sch, Y Axis Motor Driver.sch]
2020-01-21 +5V Power plane routing
    [Main Board.kicad_pcb]
2020-01-21 Routing PCB finished
    [Main Board.kicad_pcb]
2020-01-21 Silk layers finished
    [Main Board.kicad_pcb]
2020-01-22 Added Nestimo logo, generated gerber files
    [Main Board-B_Cu.gbr, Main Board-B_Mask.gbr, Main Board-B_Paste.gbr, Main Board-B_SilkS.gbr, Main Board-Edge_Cuts.gbr, Main Board-F_Cu.gbr, Main Board-F_Mask.gbr, Main Board-F_Paste.gbr]
2020-01-22 Added 3d packages, improved TMC2209 footprint
    [Main Board.kicad_pcb, Y Axis Motor Driver.sch, Z Axis Motor Driver.sch]
2020-01-22 Update gerber
    [Main Board-B_Cu.gbr, Main Board-B_Mask.gbr, Main Board-B_Paste.gbr, Main Board-B_SilkS.gbr, Main Board-Edge_Cuts.gbr, Main Board-F_Cu.gbr, Main Board-F_Mask.gbr, Main Board-F_Paste.gbr]
2020-01-23 Added EEPROM on schematic
    [Main Board.kicad_pcb, Microcontroller.sch, Sensors.sch]
2020-01-24 EEPROM Routing, Updated gerber files
    [Main Board-B_Cu.gbr, Main Board-B_Mask.gbr, Main Board-B_Paste.gbr, Main Board-B_SilkS.gbr, Main Board-Edge_Cuts.gbr, Main Board-F_Cu.gbr, Main Board-F_Mask.gbr, Main Board-F_Paste.gbr]
2020-01-24 Update elements value
    [Emergency.sch, HMI.sch, Main Board.sch, Microcontroller.sch, Power.sch, Sensors.sch, Sockets 2.sch, Sockets.sch]
2020-02-03 Update silk layer, update TMC label, added revision, serial number, generated gerbera
    [Main Board-B_Cu.gbr, Main Board-B_Mask.gbr, Main Board-B_Paste.gbr, Main Board-B_SilkS.gbr, Main Board-Edge_Cuts.gbr, Main Board-F_Cu.gbr, Main Board-F_Mask.gbr, Main Board-F_Paste.gbr]
2020-02-18 Updated BOM on schematics
    [BOM.xlsx, Emergency.sch, GrupedBOMRaw.csv, HMI.sch, Main Board.sch, Microcontroller.sch, Power.sch, Sensors.sch]
